DerekWangHUZ/sice-huawei-cup-wireless-2026/docs/FPGA实验板资料参考.md

# FPGA 实验板资料参考（学校《数字系统实验II》）

> 本文档汇总《数字系统实验 II》课程所用 **Artix-7 实验板** 的完整引脚与片上资源约束，
> 全部来自《数字系统实验 II》课程各实验的官方 XDC / 源文件，
> 并与板卡实际行为核对。本仓库 FPGA 工程（`firmware/coprocessor`）的引脚约束以本文为参考。

---

## 1. 板卡识别（务必看清，别用错芯片）

| 项 | 值 |
|---|---|
| FPGA 型号 | **XC7A35T-FTG256-1**（Artix-7，35T，256 脚 FTBGA，速度等级 -1） |
| 默认 I/O 标准 | **LVCMOS33**（3.3V，所有引脚约束都需加 `IOSTANDARD LVCMOS33`） |
| 主时钟 | **50 MHz**，晶振接 `D4` |
| 复位 | **低有效 `rst_n`**，接 `T9`（板上无上拉，设计中必须开内部 PULLUP） |

> Vivado 建工程时 **Project Type = RTL Project**，**Default Part** 选 `xc7a35tftg256-1`。

---

## 2. 时钟与复位（每个工程都必须有）

```tcl
## 50MHz 主时钟
set_property PACKAGE_PIN D4 [get_ports clk]
set_property IOSTANDARD  LVCMOS33 [get_ports clk]
create_clock -period 20.000 -name clk [get_ports clk]

## 复位（低有效）。板上无外部上拉，务必开内部 PULLUP，否则会一直卡在复位态
set_property PACKAGE_PIN T9 [get_ports rst_n]
set_property IOSTANDARD  LVCMOS33 [get_ports rst_n]
set_property PULLUP true [get_ports rst_n]
```

**约束要求**：若设计依赖 `rst_n` 而未启用内部上拉，会出现下载成功
（`End of startup status: HIGH`）但 LED 全不亮的现象——`T9` 未被拉高，
设计持续处于异步复位。**rst_n 必须开内部上拉（或在逻辑里处理成可选）。**

---

## 3. LED（16 颗，直接驱动，高电平点亮）

| 信号 | 引脚 | 信号 | 引脚 |
|---|---|---|---|
| `led[0]`  | **P9**  | `led[8]`  | **R1**  |
| `led[1]`  | **R8**  | `led[9]`  | **G5**  |
| `led[2]`  | **R7**  | `led[10]` | **H3**  |
| `led[3]`  | **T5**  | `led[11]` | **E3**  |
| `led[4]`  | **N6**  | `led[12]` | **P5**  |
| `led[5]`  | **T4**  | `led[13]` | **P1**  |
| `led[6]`  | **T3**  | `led[14]` | **N1**  |
| `led[7]`  | **T2**  | `led[15]` | **M1**  |

- 来源：课程《第六周 实验五（２）矩阵键盘按键控制 LED》约束文件（完整 16 颗）。
  课程 master 资源文件里只示范了 `Q[0..3]` + `CO`(N6)，其余以注释形式给出，与上面 16 颗完全一致。
- **极性**：**高电平点亮**（直接驱动，非反相）。验证方法：`assign led = cnt[24:9]` 时
  `led[0..10]`（对应 `cnt[9..19]`，47 Hz~48.8 kHz）肉眼"常亮"，`led[11..15]` 随比特位升高频率递减，
  即每个 `led[k]` 直接接一个计数器高位，1=亮。
- ⚠️ **板卡特性**：`led[15]`（引脚 **M1**）在本板**不点亮**——
  1Hz 同步闪烁程序下其余 15 颗正常闪、唯独 M1 无输出。属板卡个体硬件问题，**与工程/约束/下载无关**，验收时忽略即可。
- **本项目使用约定**：
  - 板上共 **17 颗 LED**（丝印 LED0~LED16）。课程 XDC 只提供 16 个引脚映射，
    **丝印 LED16 没有引脚映射**，任何比特流都不会驱动它——它不亮是"没接"而非"坏了"。
  - **LED12~LED16 按项目要求禁用**：工程只驱动 `led[0..11]`（主排 12 颗），
    `led[15:12]` 在 `rtl/led_ctrl.v`（`LED_COUNT=12`）与 `rtl/top.v` 掩码下恒输出灭。
  - `led[11]` 兼作链路灯：无链路 0.5Hz 慢闪，已链路每帧闪 60ms（契约 §4.8）。

---

## 4. UART（板上 USB-UART 桥）

```tcl
# set_property PACKAGE_PIN F12 [get_ports txd]
# set_property IOSTANDARD  LVCMOS33 [get_ports txd]
# set_property PACKAGE_PIN F13 [get_ports rxd]
# set_property IOSTANDARD  LVCMOS33 [get_ports rxd]
```
- `txd → F12`，`rxd → F13`（LVCMOS33）。F12/F13 接**板上 USB-UART 桥**
  （板右侧独立 UART USB 口，与 JTAG 口并排），供 PC 串口通信使用，
  **未引出至排针**；外部设备对接 UART 请使用扩展排母的空闲引脚。
- 本项目（`firmware/coprocessor`）S3 → FPGA 的 rxd 使用扩展排母
  **B15**（右排母上排第 1 脚，同排末位 GND），约束见
  `firmware/coprocessor/constrs/pins.xdc`。

---

## 5. 矩阵键盘（按键 / 键盘扫描）

| 信号 | 引脚 | 信号 | 引脚 |
|---|---|---|---|
| `row[0]` | **K3** | `col[0]` | **R12** |
| `row[1]` | **M6** | `col[1]` | **T12** |
| `row[2]` | **P10** | `col[2]` | **R11** |
| `row[3]` | **R10** | `col[3]` | **T10** |

- 来源：master 资源文件 `##Buttons` +《第七周 实验六（２）电子琴》约束。
- ⚠️ **上拉/下拉不一致（官方两处写法不同）**：
  - 电子琴 XDC：`set_property PULLUP true [get_ports {col[3..0]}]`（列线上拉）
  - master 资源文件：`set_property PULLDOWN true [get_ports {col[3..0]}]`（列线下拉）
  - 实际用哪种取决于板子矩阵接法；**建议按键盘扫描惯例“列线输出、行线输入+上拉”对接，并在代码中做消抖**。

---

## 6. 拨码开关 `sw[0..11]`（与复位/数码管地址复用，注意冲突）

| 信号 | 引脚 | 信号 | 引脚 |
|---|---|---|---|
| `sw[0]`  | **T9**  | `sw[6]`  | **P4**  |
| `sw[1]`  | **T8**  | `sw[7]`  | **R3**  |
| `sw[2]`  | **T7**  | `sw[8]`  | **R2**  |
| `sw[3]`  | **R6**  | `sw[9]`  | **N4**  |
| `sw[4]`  | **P6**  | `sw[10]` | **H4**  |
| `sw[5]`  | **R5**  | `sw[11]` | **F3**  |

⚠️ **引脚复用冲突（务必注意）**：
- `T9` 同时是 **`rst_n`（复位）** 和 `sw[0]` —— 二者不能在同一工程里同时当独立信号用。
- `T8 / T7 / R6` 同时出现在数码管译码实验的 `ain[1] / ain[2] / ain[3]`（见第 7 节）。
- 同一工程要用开关又要用复位/数码管时，需分时复用或改接，不要简单把它们全部分配。

**本项目使用约定**（`pins.xdc` §3b）：
- `sw[0]`（T9）因与复位冲突**不可用**；`T8/T7/R6` 与本工程实际用到的数码管
  引脚无冲突（本工程不使用 ain 信号），可安全作为拨码输入。
- 本工程使用 `sw[1]`(T8) = 演示模式总开关、`sw[2]`(T7) = 本地硬静音，
  均开内部 PULLUP；其余 9 位拨码留作扩展，未约束。
- 极性（拨上=1 还是拨下=1）以实板为准；若相反，在 RTL 取反一处即可。

---

## 7. 数码管（7 段 × 6 位）

| 段信号 | 引脚 | 位选信号 | 引脚 |
|---|---|---|---|
| `seg[0]` | **P11** | `an/dig[0]` | **G12** |
| `seg[1]` | **N12** | `an/dig[1]` | **H13** |
| `seg[2]` | **L14** | `an/dig[2]` | **M12** |
| `seg[3]` | **K13** | `an/dig[3]` | **N13** |
| `seg[4]` | **K12** | `an/dig[4]` | **N14** |
| `seg[5]` | **P13** | `an/dig[5]` | **N11** |
| `seg[6]` | **M14** | 小数点 `dp` | **V7**（注释） |
| `seg[7]` | **L13** | | |

- 来源：master 资源文件 `##7 segment display` +《第二周 实验二（２）数码管》约束。
- master 用 `an[0..5]`，数码管实验用 `dig[0..5]`，**引脚完全相同**，仅为命名差异。
- 译码段码（共阴极，段选高电平亮）参考课程 `decoder_7seg`：
  `0→11111100, 1→01100000, 2→11011010, 3→11110010, 4→01100110, 5→10110110, 6→00111110, 7→11100000, 8→11111110, 9→11100110`。

---

## 8. 蜂鸣器与 DAC

**蜂鸣器**
```tcl
set_property PACKAGE_PIN L2 [get_ports buzzer]
set_property IOSTANDARD  LVCMOS33 [get_ports buzzer]
```
- 来源：电子琴实验 XDC。

**DAC（8 位）**
| 信号 | 引脚 | 信号 | 引脚 |
|---|---|---|---|
| `DAC_CS`  | **H2** | `DAC_DATA[0]` | **G1** |
| `DAC_WR`  | **H1** | `DAC_DATA[1]` | **G2** |
| `DACAB` | **J3** | `DAC_DATA[2]` | **F2** |
| | | `DAC_DATA[3]` | **E1** |
| | | `DAC_DATA[4]` | **L3** |
| | | `DAC_DATA[5]` | **K1** |
| | | `DAC_DATA[6]` | **K2** |
| | | `DAC_DATA[7]` | **J1** |

- 来源：master 资源文件 `##DAC`（全部以注释形式给出）。

---

## 9. 板卡特性与验证方法

1. **下载成功标志**：Vivado `Program Device` 日志末尾出现 `End of startup status: HIGH` ⇒ 比特流已配置、DONE 拉高、设计在运行。
2. **时钟验证法**：把 25 位计数器 `cnt` 的高 16 位直接接 `led`（`assign led = cnt[24:9]`），
   若 LED0~10 常亮、11~15 频率递减 ⇒ 50MHz/D4 时钟在跑、led 引脚全对。
3. **`led[15]`=M1 在本板不点亮**（见 §3），属板卡个体硬件问题，非工程问题。
4. **复位要求**：`rst_n`(T9) 必须启用内部上拉，否则设计持续处于复位、LED 全灭。

---

## 9b. 配置 Flash 与上电启动（掉电持久化）

`Program Device`（JTAG）写的是 **FPGA 内部 SRAM，掉电即失**；
> 要让板子自己从 Flash 启动，须把比特流写进板载配置 Flash。

- **器件**：Vivado 硬件管理器自动识别为 Micron **N25Q32-3.3V**（ID：Mfg `20` /
  Type `ba` / Cap `16`），对应 `get_cfgmem_parts` 中的
  **`n25q32-3.3v-spi-x1_x2_x4`**（32Mbit = 4MB）。
- **生成烧写文件**：`write_cfgmem -format mcs -size 32 -interface SPIx1`（见
  `firmware/coprocessor/gen_mcs.tcl`）。`-size 32` 对应 32Mbit；
  `SPIx1` 与工程默认 `SPI_BUS_WIDTH=1` 一致，最保守可靠。
- **烧写入口**：GUI 的 **Program Configuration Memory Device**（只接受
  `.mcs`/`.bin`，**不接受 `.bit`**），或仓库内的无头脚本
  `firmware/coprocessor/program_mcs.tcl`。
  后者内部会先加载 Vivado 自带的 SPI 桥接位流
  （`spi_xc7a35t_pullnone.bit`，位于 Vivado 安装目录
  `data/xicom/cfgmem/`），这是 JTAG 间接访问 Flash 的必要前置步骤；
  GUI 会自动完成这一步，手写 Tcl 时须显式加载，遗漏时报
  `[Labtools 27-3347] Failure to set flash parameters`，其根因见
  `readback_hw_cfgmem` 的 `27-3138 indirect programming
  bitstream was not found`。
- **改 RTL 后必须重新固化**，否则上电运行的仍是 Flash 中原有比特流；临时验证
  可用 JTAG 下载（掉电即失，不影响 Flash 内容）。

### ⚠️ 板级特性：上电不会自动触发配置

**现象**：Flash 烧写成功并通过校验后，断电再上电时板子**不会自动启动**——
`DONE` 保持为 0，数码管/LED/蜂鸣器全无反应。**手动按一下板上 CONFIG 按钮**，
立即正常启动并运行 Flash 中的设计。

**以下因素与该现象无关**（按下 CONFIG 能启动即可佐证）：

| 无关因素 | 依据 |
|---|---|
| Flash 内容/比特流有问题 | 按 CONFIG 能正常加载运行 |
| 启动模式（MSEL）不对 | 按 CONFIG 说明确实在读 SPI Flash |
| 烧写方式/工具链有问题 | `Erase`/`Program`/`Verify` 全部成功，读回校验一致 |
| mcs 格式有问题 | 与 Vivado 自带样例 `ac701_test.mcs` 结构逐字段一致 |

**失效环节仅在于"上电瞬间的自动触发"**。CONFIG 按钮接的是 FPGA 的
`PROGRAM_B`（低有效配置复位）；它能手动生效、上电却不生效，指向板级的
上电复位电路/电源上升沿问题，属**硬件层面**。

**以下设置与上电触发无关**：

- 在 XDC 中设置 `BITSTREAM.CONFIG.PROGPIN/INITPIN/DONEPIN = Pull-up`
  （以 FPGA 内部弱上拉替代板上外部上拉）。
- `CFGBVS` 与 `CONFIG_VOLTAGE` 属性（该设置用于消除 DRC 的
  `CFGBVS-1` 告警，与上电触发无关）。

**本板行为：上电后必须按一次 CONFIG 才会从 Flash 启动。**
该现象属板级上电复位电路/电源上升沿特性，**硬件层面**，软件侧无法规避。

**可行的应对方式**（均需人工或额外硬件）：

1. 上电后按一次 CONFIG 按钮（最简单的方式）。
2. 用 `program_bit.tcl` 经 JTAG 下载（需要电脑，不满足"脱离电脑"要求）。

**若要实现全自动而又不动配置电路**，可用 ESP32-S3 的一个空闲 GPIO
接 FPGA 的 `PROGRAM_B`，上电后由 S3 主动拉低 100ms 再释放，等效于按一次
CONFIG。此方案需增加一根飞线，且需占用 S3 的一个空闲 GPIO。

- 烧写失败不会损坏 JTAG 通路：配置 Flash 内容异常时 FPGA 只是不启动，
  仍可用 `program_bit.tcl` 重新下载比特流。

---

## 10. 最小可复用 XDC（时钟 + 复位 + 16 LED）

新建工程后，把下面内容直接贴进 `pins.xdc`（按需再补 UART / 键盘 / 数码管 / DAC）：

```tcl
## Clock: 50MHz on D4
set_property PACKAGE_PIN D4 [get_ports clk]
set_property IOSTANDARD  LVCMOS33 [get_ports clk]
create_clock -period 20.000 -name clk [get_ports clk]

## Reset (active-low). Board has NO pull-up -> enable internal PULLUP
set_property PACKAGE_PIN T9 [get_ports rst_n]
set_property IOSTANDARD  LVCMOS33 [get_ports rst_n]
set_property PULLUP true [get_ports rst_n]

## 16 LEDs (led[15]=M1 is physically dead on this board)
set_property PACKAGE_PIN P9  [get_ports {led[0]}]
set_property PACKAGE_PIN R8  [get_ports {led[1]}]
set_property PACKAGE_PIN R7  [get_ports {led[2]}]
set_property PACKAGE_PIN T5  [get_ports {led[3]}]
set_property PACKAGE_PIN N6  [get_ports {led[4]}]
set_property PACKAGE_PIN T4  [get_ports {led[5]}]
set_property PACKAGE_PIN T3  [get_ports {led[6]}]
set_property PACKAGE_PIN T2  [get_ports {led[7]}]
set_property PACKAGE_PIN R1  [get_ports {led[8]}]
set_property PACKAGE_PIN G5  [get_ports {led[9]}]
set_property PACKAGE_PIN H3  [get_ports {led[10]}]
set_property PACKAGE_PIN E3  [get_ports {led[11]}]
set_property PACKAGE_PIN P5  [get_ports {led[12]}]
set_property PACKAGE_PIN P1  [get_ports {led[13]}]
set_property PACKAGE_PIN N1  [get_ports {led[14]}]
set_property PACKAGE_PIN M1  [get_ports {led[15]}]
set_property IOSTANDARD LVCMOS33 [get_ports {led[15]}]
set_property IOSTANDARD LVCMOS33 [get_ports {led[14]}]
set_property IOSTANDARD LVCMOS33 [get_ports {led[13]}]
set_property IOSTANDARD LVCMOS33 [get_ports {led[12]}]
set_property IOSTANDARD LVCMOS33 [get_ports {led[11]}]
set_property IOSTANDARD LVCMOS33 [get_ports {led[10]}]
set_property IOSTANDARD LVCMOS33 [get_ports {led[9]}]
set_property IOSTANDARD LVCMOS33 [get_ports {led[8]}]
set_property IOSTANDARD LVCMOS33 [get_ports {led[7]}]
set_property IOSTANDARD LVCMOS33 [get_ports {led[6]}]
set_property IOSTANDARD LVCMOS33 [get_ports {led[5]}]
set_property IOSTANDARD LVCMOS33 [get_ports {led[4]}]
set_property IOSTANDARD LVCMOS33 [get_ports {led[3]}]
set_property IOSTANDARD LVCMOS33 [get_ports {led[2]}]
set_property IOSTANDARD LVCMOS33 [get_ports {led[1]}]
set_property IOSTANDARD LVCMOS33 [get_ports {led[0]}]
```

---

## 11. 板子照片

实验板实物照片（来自课程目录，已存入仓库）：

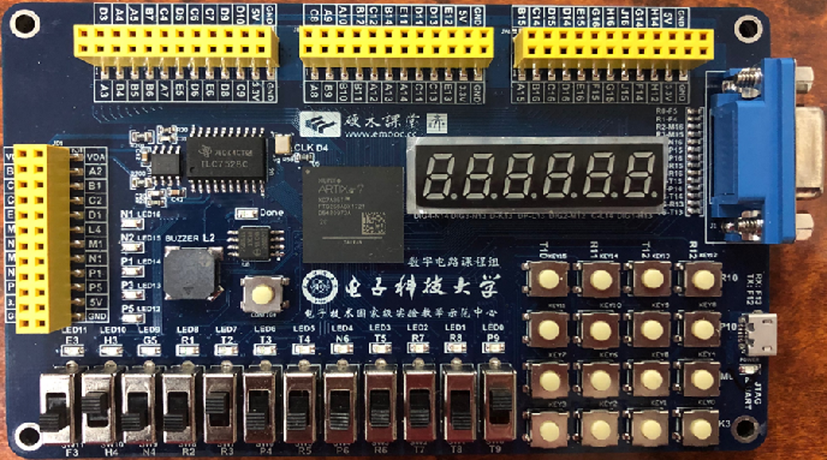
[picture p1: hardware/photos/fpga-board.png]
实验板照片


> 官方原理图不在仓库内；如需引用请置于 `hardware/schematics/`。
