DerekWangHUZ/sice-huawei-cup-wireless-2026/docs/CHANGELOG.md

# CHANGELOG

> 记录本项目架构层面的重要变更与决策依据。代码级细碎改动不在此列。
> 格式参考 [Keep a Changelog](https://keepachangelog.com/zh-CN/1.1.0/)，本项目未对外发布，暂不使用版本号。

---

## [2026-10-31] CSI 上机排查：驱动配置层两层修复 + v6.1 SoftAP ESP_FAIL 坐实

> 目标：打通 real 构建的 SoftAP CSI 采集（sigma_csi 标定的前置）。
> 结果：驱动配置层问题全部修复；剩余一层为 IDF v6.1 驱动对 SoftAP
> CSI 的未文档化拒绝（ESP_FAIL），已实测坐实并转仓库 issue 跟踪。

### 一、构建环境修复（本机）

- ESP-IDF python venv 指向的基座解释器 Python 3.14 已被卸载（本机现为
  3.15.2），venv 启动器失效：pyvenv.cfg 重指 Python315，并以官方 PyPI
  升级 pydantic/cffi/bitarray/charset-normalizer/cryptography(48)/psutil
  ——cryptography 须 <49（约束文件），50.x 会被 idf.py 环境检查拒绝。
- 修复后 `idf.py build` / `flash` 全流程恢复。

### 二、CSI 上机排查（三层定位，前两层已修复）

| 层 | 现象/原因 | 处置 |
|---|---|---|
| 1 | `CONFIG_ESP_WIFI_CSI_ENABLED` 未开：WiFi 驱动初始化时 CSI 能力缺失，`set_csi_config` 直接 ESP_FAIL | sdkconfig 置 y——注意直接改 sdkconfig 会被 confgen 回退（生成头文件中符号消失，机制待查），现以编译注入 `-DCONFIG_ESP_WIFI_CSI_ENABLED=1` 兜底 |
| 2 | v6 起 CSI 与混杂模式耦合：未开 promiscuous 同样 ESP_FAIL | `csi_init()` 内置 `esp_wifi_set_promiscuous(true)`（串口日志 `ic_enable_sniffer` 证实生效） |
| 3 | 满足 1/2 后 `set_csi_config` 仍 ESP_FAIL：延迟到 SoftAP 完全就绪且 STA 推流中（首帧延迟初始化），LLTF-only 与 LLTF+HT-LTF 两种配置均被拒 | **未解**：v6.1 驱动对 SoftAP CSI 的支持变化（未文档化），转仓库 issue；候选路径为 v5.5 工具链采集固件或 STA 模式方案 |

### 三、源码变更（base_station）

- `csi_init()` 内置 promiscuous 使能 + 两种 CSI 配置组合依序尝试；
- `base_station.c` CSI 初始化改为**首帧延迟初始化**
  （`csi_late_init_if_needed`，udp_pose_task 首帧触发）：
  替代原"esp_wifi_start 后立即初始化"的时序；
- `csi_stub.h`/`csi_real.c`/`base_station.c` 头注同步为当前事实口径；
- 失败路径保持 fail-open：CSI 缺失不影响 IMU 主判据，行为与 stub 一致。

### 四、验收证据

- 串口启动日志（COM4）：`ic_enable_sniffer` 证实 promiscuous 生效；
  `set_csi_config try 1/2 failed: ESP_FAIL` 证实双配置均被拒；
- 推流链路正常：`STATS packets=219→1972 frames_ok=100% mag=0.99~1.00g`；
- real 构建编译通过（bin 949,504 B），烧录校验一致。

### 五、未覆盖事项

- SoftAP CSI 的 ESP_FAIL（issue 跟踪）解决前，real 构建的 CSI_Variance
  列仍为 0，CSI_JUDGE_ENABLE 保持关闭（fail-open）；
- sigma_csi 三状态标定、姿态门佩戴标定：待 CSI 采集打通后进行。

---

## [2026-10-26] 摄像头恢复启用 + 全套离线验证收尾 + 文档口径清理

> 三件事：① 摄像头模组恢复可用，`CAMERA_BOOT_ENABLE` 默认翻回 1；
> ② 上一条目遗留的全部离线验证在本机（D 盘仓库机器）补齐；
> ③ 根 README 与 docs/（除本文件）按"当前事实"口径清理历史痕迹表述。

### 一、摄像头恢复启用（联动固件 + 文档）

- 摄像头模组恢复可用（用户确认），`wearable_firmware.ino` 的
  `CAMERA_BOOT_ENABLE` 默认值 0 → **1**（全功能启动：摄像头三段自检 +
  闪光灯 + 网页 + /pic）；宏注释改写为中性的编译期功能开关说明，
  置 0 仍可用于隔离摄像头链路或最小化运行。
- 双向编译验证（arduino-cli 1.5.2 / esp32 core 3.3.12 /
  FQBN `esp32:esp32:esp32cam:PartitionScheme=huge_app,FlashMode=dio,FlashFreq=40`）：
  默认(=1) 与临时置 0 均 **0 error / 8 warning**（全部为既有
  volatile 计数器 `++` 的 `-Wvolatile` C++20 弃用告警）；
  bin 体积 1,090,149 B（=1，34% of 3MB）/ 938,725 B（=0，29%）。
- 2026-10-25 条目中"摄像头硬件故障停用"的前提自此作废。

### 二、离线验证收尾（本机执行，全部通过）

| 验证项 | 结果 |
|---|---|
| 穿戴端固件（两宏配置） | 0 error（见上） |
| 离线自测 | `ALL 19` + `ALL 22 SCENARIOS PASSED`，总 PASS |
| 基站 ESP-IDF v6.1 默认 stub | 0 error/0 warning，bin 947,744 B（分区余量 10%） |
| 基站 `-DBS_CSI_IMPL=real` | 0 error/0 warning，bin 948,992 B（9%） |
| 基站 `-DCSI_JUDGE_ENABLE=1` | 0 error/0 warning，bin 947,776 B（10%） |
| FPGA 无头仿真（Vivado 2026.1） | `SIM RESULT: PASS`（86 项断言） |

### 三、脚本与文档

1. **`run_offline_tests.ps1` 补 lcc64 第二构建**：实测 lcc64 支持 `-D`，
   posture-gate 构建不再对 lcc64 跳过；同时总结果增加 `$postureBuilt`
   硬门禁（第二构建失败 = FAIL，不再可能静默弱化）。
2. **文档口径清理**（根 README + docs/ 除本文件外全部）：删除日期标注、
   修订叙事（"第 N 次上板实测修订/此前为误判/已实现/改回恢复"等），
   统一为现在时态的中性事实陈述；摄像头能力恢复全功能表；顺带修正
   过时数字（离线 17 场景 → 19+22；FPGA 仿真 60 断言 → 86）。
   **firmware/ 内部文档（wearable README、tests README）按指示未动**，
   其中摄像头停用期描述与现默认行为不符，待团队自行刷新。
3. 本机构建注记：idf.py 须在 PowerShell 进程内 `Remove-Item Env:MSYSTEM`
   后经 EIM profile 激活（`env -u`/置空均会被重注入）；仓库内
   `firmware/base_station/build/` 为另一路径机器生成的失效缓存，已删除，
   首次构建请用全新构建目录。

### 四、实机冒烟测试（2026-10-26 当日，基站 + 穿戴端上电）

- **基站（ESP32-S3，COM4/CH343）**：暂存版固件烧录成功（947,872B 校验一致）
  并完整启动——SD 挂载记录 `DATA_115.CSV`、OLED 就绪、FPGA UART 就绪并
  发送音频配置与心跳、`CSI stub active` 初始化日志正确、SoftAP/DHCP 池
  （.2 保留）/UDP 8888 全部就绪，STATS 周期稳定无重启。未接穿戴端时
  `packets=0 state=IDLE`，符合预期。FPGA 板未接入，上行链路未测。
- **穿戴端（ESP32-CAM，COM9/CH340 TTL）**：板上固件实机通过 MPU 初始化
  （WHO_AM_I=0x74）与摄像头自检（`[CAMERA] post-MPU selftest OK: 8601 bytes`）。
  USB 供电不足导致 WiFi 启动阶段看门狗复位（一轮为 TG1WDT、一轮摄像头
  init 返回 0x106 后 TG0WDT 快速复位循环）——同版固件在供电充足时摄像头
  与 MPU 自检可过，属供电问题非固件缺陷；网络链路与抓拍全流程待稳定供电
  （充电宝 5V）后回归。穿戴端烧录须经 MB 底板（自动下载），COM9 TTL 接法
  仅可运行不可烧录。
- **烧录口径修正**：穿戴端 README 移除"按住 IO0、短按 RST"的手动下载步骤
  （本工程烧录由 MB 底板自动完成，与板上按键无关）；穿戴端 README 全文按
  摄像头全功能现状同步改写（§0/§2/§4/§5/§6/§7/§8/§9）。
- **50 Hz 数据链路实机打通**：穿戴端（MB 底板供电）与基站完成全链路——
  基站 `packets=2812 frames_ok=2812 frames_bad=0 mag=0.98g`（静止重力值，
  数值链路正确），穿戴端连续推流 `UDP #3492 fail=0`（新增发送失败计数
  为 0，序号=成功发出帧数语义生效）；WiFi 断线自愈（基站复位后 2.4s 内
  自动重连）实机验证通过。
- **新增操作约束文档（wearable README §5.3）**：CAM 插 MB 底板（烧录姿态）
  与接 MPU 排线（运行姿态）物理互斥——烧录姿态下 MPU 必然离线、不发帧，
  "无数据"属预期；运行姿态下无法烧录，Upload 连不上先核对物理姿态；
  姿态切换须重新上电（MPU 仅在 setup() 初始化）。此前"穿戴端无数据"
  的现象即烧录姿态下的预期表现，非链路故障。

### 未覆盖 / 已知事项（需上机）

- 上机三件套不变：CSI（S3 AP 模式回调确认 → sigma_csi 三状态标定 →
  翻转 `CSI_JUDGE_ENABLE=1` 回归）、姿态门佩戴标定四步、整机联调。
- 穿戴端烧录配置口径：README §6 写 FlashFreq 40MHz，仓库中上一份实机
  烧录构建（arduino 缓存）实际为板默认 80MHz；本次验证按 40MHz。
  两者均可编译，上机时确认一次口径即可。
- 穿戴端 README（firmware/ 内部）仍含摄像头停用期描述（§4/§7/§8），
  与默认=1 的启动日志不同；不影响运行，团队可按需刷新。

---

## [2026-10-25] 离线代码质量加固 + CSI 数据通路落地 + 文档-代码对齐

> 本次全部改动**纯离线验证**（无板）：基站经 ESP-IDF v6.1 完整编译 +
> 离线自测双构建回归；穿戴端无编译环境，逐行人工核验（见"未覆盖"）。

### 一、基站（可编译验证 + 离线回归）

1. **离线自测恢复可移植**：`run_offline_tests.ps1` 编译器/Python 探测参数化
   （gcc → MSVC vcvars → lcc64 后备），并新增**第二构建**
   `test_harness_posture.exe`（`-DPOSTURE_CHECK_ENABLE=1`），两个二进制
   都必须全绿才算 PASS。原脚本硬编码 MATLAB lcc64 路径，换机即失效。
2. **姿态门离线场景组补全**（`POSTURE_CHECK_ENABLE` 的门逻辑 2026-10-18
   已完整落地但从未被离线测试覆盖）：场景 18 校准后跌倒躺平→照常 CONFIRMED、
   场景 19 校准后快速坐下→门拦截不报警（magnitude-only 判定的头号误报源）、
   场景 20 未校准 fail-open 与门关闭行为逐位一致。`gen_frames.py` 新增
   三个姿态场景合成帧（直立校准 2.1s / 躺平重力 +Y 夹角 ~82° / 坐姿 ~6°）。
   `fall_core.h` 姿态门宏加 `#ifndef` 守卫并补**佩戴标定流程四步**注释；
   默认值保持 0（待成员 B 上机标定后再翻转）。
3. **代码级修复**：
   - `fpga_link.c` 发送帧间隔保护由"持锁自旋烧 CPU"改为 `vTaskDelay(1)`
     分片等待（帧间隔语义不变：互斥仍持有、间隔只会更长不会更短）；
   - `settings.c` NVS 写入改**增量脏写**（影子副本 s_saved 对比，只写变更
     key；旧实现每次调节写满 8 个 key，磨损放大 8 倍），同时修复 5 处
     `snprintf(buf, n, 非字面格式串)` 的 format-security 隐患；
   - `sd_log.c` 无卡探活加指数退避（前 3 次逐周期重试，之后 4/8/16 周期
     封顶）：全量 `sd_log_init()`（SPI init+挂载）一次耗几十上百 ms，
     无卡时逐周期重试会周期性阻塞 UI 任务；
   - `fpga_uplink.c` UART 逐字节读改批量读（32B/次）；`s_last_ms`（int64，
     32 位 Xtensa 上跨任务撕裂读）加 portMUX 短临界区；
   - `oled_display.c` 删除内联 isqrt 拷贝，复用 `fall_core` 导出的
     `fall_isqrt_u32`（同算法两份拷贝漂移风险）；遥测页 `row` 缓冲 24→32B
     并对角速度显示加 999.9 物理限幅（否则触发
     `-Werror=format-truncation`）；
   - `base_station.c` DHCP 池 `htonl(0xC0A8040A)` 魔法数改 `IP4_ADDR` 宏。
4. **评估后明确不改**（记录决策防后人重议）：任务看门狗订阅、SoftAP 初始化
   失败向上传播——需上机观察，纯离线阶段不动运行时行为。

### 二、CSI 数据通路（"通感"卖点落地到编译级）

- **新增 `csi_stats.c/h`（纯 C99，进离线自测）**：子载波 IQ→幅度
  （复用 `fall_isqrt_u32`）→单帧子载波间方差（一阶公式
  `(N·Σx²-(Σx)²)/N²`，回调上下文只累加不做除法）→10 帧滑窗平均。
  离线场景 21/22 锁死：方差精确值、ready 状态机、commit 节流（无新快照
  不重复入窗）、滑窗环形覆盖、非法输入拒绝。
- **新增 `csi_real.c`（编译期由 `main/CMakeLists.txt` 的 `BS_CSI_IMPL`
  选择，默认 stub）**：`esp_wifi_set_csi_config`(LLTF only，关闭相邻子载波
  滤波——滤波会抹平方差特征) + `set_csi_rx_cb` + `set_csi(true)`；
  子载波数取 `csi_info->len/2`（不假设固定 64，S3 与 ESP32 classic 数量不同）。
  采集源即穿戴端 STA 的 50Hz 上行包（ESP-CSI 只对本机收发的帧触发，
  esp-csi#247），`csi_feed_packet()` 的调用点天然节流。
- **`fall_core` CSI 辅助判据钩子（`CSI_JUDGE_ENABLE` 默认 0）**：
  `fall_detector_set_csi()` 喂入窗口方差，确认门增加"方差 < sigma_csi"
  分支；未就绪 fail-open（CSI 缺失绝不比纯 IMU 更保守漏报）。宏带
  `#ifndef` 守卫，与姿态门同一开关模式。
- **接口扩展**：`csi_stub.h` 新增 `csi_init()`（esp_wifi_start 后调用），
  stub 为空操作；头注由"6 步 TODO"改写为"已实现/待上机"两栏。
- **三种配置均编译验证通过**：默认 stub / `BS_CSI_IMPL=real` /
  `CSI_JUDGE_ENABLE=1`（默认构建产物与历史行为逐字节同源）。

### 三、穿戴端（无编译环境，人工核验）

1. **实现 `CAMERA_BOOT_ENABLE`（修复"README 有、代码无"的缺口）**：
   wearable README §4/§7 自 c5bd068 起描述该宏及其启动锚点，但对应代码
   未提交。现补齐：默认 0（摄像头硬件故障期）跳过摄像头初始化/三段自检/
   闪光灯/网页服务，打印 `[CAMERA] disabled` / `[HTTP] not started:
   CAMERA_BOOT_ENABLE=0` / `[CAPTURE] disabled` 三锚点（与 README §7
   逐条对齐）；MPU 50Hz 推流与 8889 命令接收（校验+日志）不受影响；
   改回 1 即恢复全部功能。
2. `app_httpd.cpp` 修复 vendored 遗留 bug：`char *part_buf[128]`（128 个
   指针，本意 128 字节 scratch）→ `char part_buf[128]`。
3. `sendImuPacket` 检查 `write/endPacket` 返回值：三步全成才递增
   `packetSequence`（序号=成功发出的帧数），失败计入 `g_udpSendFail`
   随 200ms 诊断行汇报（旧实现失败也递增序号，掩盖发送故障）。
4. 8889 未知命令打印限流（每 5 秒最多一条，端口对全网开放时防刷屏）。
5. 本地跌倒检测阈值与基站 `fall_core.h` 对齐（旧 2.2g/180dps/0.75~1.25g/
   25dps/800ms/3000ms → 3.0g/—/0.65~1.35g/50dps/1500ms/4000ms），
   消除"本地报跌倒、基站不报"的双阈值漂移；注释明确其为仅串口诊断，
   不上报（18B 协议无本地判定字段）。
6. **评估后保留** `wifi_keepalive` 内 `delay(20/50)`：仅发生在链路切换
   时刻（此时数据流本已中断），而 socket 清理时序是上板验证过的修复
   （c5bd068），无法编译+上板验证前不改动。

### 四、文档对齐（代码为准）

- 键映射修正：契约 §4.9 与说明书 §三 原文"上行键号 = 15 - pos（左上角
  KEY15）"改为"= pos（扫描起点一角 KEY0，恒等映射）"——第四次上板反馈
  （2026-10-19 同日修订第 1 条）已实测推翻 15-pos，但两份文档未同步，
  排布图一并纠正。
- 根 README：穿戴端能力表逐项标注停用/可用；目录树补 `CHANGELOG.md`、
  `algorithm/`、`data/` 标注"预留待成员 C 交付"；CSI 表述由"预留接口"
  更新为"数据通路已实现、默认未启用、判据待上机标定"。

### 验证

- 离线自测：默认构建 19 场景 + 姿态门构建 22 场景，全部 PASS
  （MSVC cl 编译，脚本自动探测）。
- 基站固件：ESP-IDF v6.1 + xtensa-esp-elf 15.2.0 完整编译三种配置
  （stub/real/判据开启）全部通过，默认配置 bin 947KB，分区余量 10%。
- CSI API 编译级验证以本机 `esp_wifi.h` 头文件实际签名为准
  （`wifi_csi_config_t` 九字段、`wifi_csi_info_t.len`、`esp_wifi_set_csi_rx_cb`）。

### 未覆盖 / 已知事项（需上机）

- **穿戴端全部改动未经编译验证**（本机无 arduino-cli，沿仓库既有惯例）：
  烧录前建议先 Arduino IDE 编译一次确认零错误，重点看 `CAMERA_BOOT_ENABLE`
  两分支与 `checkFall` 改动。
- CSI 三件上机事项（详见 `csi_stub.h` 头注）：① S3 AP 模式回调确触发
  （`csi_ready()` 变 true）；② 标定 sigma_csi（静止/活动/躺平三状态采集
  CSI_Variance 序列取分界，填 `CSI_FALL_VAR_MAX`）；③ 翻转
  `CSI_JUDGE_ENABLE=1` 并回归全部场景。
- 姿态门待成员 B 确定佩戴方案后按 `fall_core.h` 标定流程四步执行，
  再翻转默认值。
- 本机构建注记：xtensa-gcc 15.2 全并行编译 `esp_lcd_panel_rgb.c` 会触发
  编译器内部错误（ira pass 段错误，间歇性），`-j2` 稳定；另 idf.py 拒绝
  MSYSTEM 环境（Git Bash 会向原生子进程重注入），须在 cmd 内
  `set MSYSTEM=` 后驱动 cmake+ninja——本机入口 `build_bs.cmd`（不入库，
  已加入 .gitignore）。

---

## [2026-10-19] 穿戴端联调收尾：抓拍命令端口、帧缓冲与流稳定性

### 现象与定位

穿戴端接入基站后依次暴露以下问题：

1. **Brownout 无限重启**：`setup()` 走到 `WiFi.mode(WIFI_STA)` 时触发
   `E BOD: Brownout detector was triggered`，随后 `rst:0x3 (SW_RESET)` 循环，
   永远到不了 `WiFi connected`。射频上电瞬间的电流冲击把供电拉到阈值以下。
2. **抓拍无响应、`/pic` 一直 404**：基站侧日志有
   `snap cmd sent to 192.168.4.2:8889`，但穿戴端不闪灯、不存图。
3. **连续出帧能力不足**：`fb_count = 2` 时 `httpd_resp_send_chunk()` 阻塞发送
   会占住缓冲，驱动补不上新帧，`esp_camera_fb_get()` 偶发返回 `NULL`。

### 修复

- **Brownout**：关闭检测器。地址为 `RTC_CNTL_BROWN_OUT_REG`，即
  `DR_REG_RTCCNTL_BASE(0x3ff48000) + 0xd4 = 0x3ff480d4`。检测器在供电临界时
  会无限复位，反而比"电压真崩时死机"更糟。
- **抓拍命令端口**：`udp.begin(8889)` 之前先 `udp.stop()`。
  WiFi 未连上时 `begin()` 会失败且 socket 可能留在半开状态，后续再次 `begin()`
  依然失败；不清理状态就会导致 `commandPortReady` 永久为 `false`，
  `checkCaptureCommand()` 直接返回，抓拍从此不再响应。`wifi_keepalive()`
  重连后的重新绑定同样照此处理。
- **帧缓冲**：`fb_count` 由 2 提升到 4，分辨率在初始化时直接设为 `QVGA`
  （避免先按 `UXGA` 分配再降档）；`stream_handler` 对取帧失败做 10 次重试
  （每次 50 ms），瞬时竞争不再中断已建立的流。
- **诊断计数**：新增 `g_captureCmdRx / g_captureReject / g_captureOk /
  g_captureFail`，经 `/status` 暴露，不接串口即可判断抓拍卡在哪一步。
- **三段自检**：在 `esp_camera_init()`、`setupLedFlash()`、`setupMpu()` 之后
  各取一帧并打印结果，使「初始化成功但取图失败」与「外设干扰」可从串口区分。
- **WiFi 健壮性**：启动等待加入 30 秒重试（重试时同步重设静态 IP）；
  运行期新增 `wifi_keepalive()`，每 3 秒检查、断线 6 秒重连，
  基站重启后无需人工断电。
- **I2C 超时**：`MPUWire.setTimeOut(50)`，避免 MPU 掉线时 Wire 阻塞拖死主循环。
- **摄像头/MPU 失败容错**：任一初始化失败只跳过对应功能，不中断推流主链路。

### 验证

- 姿态推流：基站 `STATS packets=116593 frames_ok=116593`，稳定 50 Hz。
- 三段自检：`selftest OK: 8518 bytes` / `post-LED selftest OK: 8311 bytes` /
  `post-MPU selftest OK: 8779 bytes`。
- 网页：`/` 200（42079 字节）、`/status` 200、`/capture` 200（JPEG）、
  `/stream` 连续 15 秒不断开。
- 抓拍链路：跌倒判定 `IDLE -> PENDING -> CONFIRMED` 后下发
  `snap cmd sent to 192.168.4.2:8889`；`/status` 显示
  `cmd_port_ready=1 cmd_rx=4 ok=4 fail=0`，`/pic` 返回有效 JPEG。

---

## [2026-10-19] 穿戴端固件并入正式工程：异步抓拍 + `/pic` + UDP 8889 命令

### 变更内容

- **穿戴端固件替换为联调版**：`firmware/wearable/main/wearable_firmware/wearable_firmware.ino`
  并入基站联调分支的实现，新增以下能力（协议 §1.2 / §1.3 零改动）：
  - UDP `8889` 抓拍命令处理：校验 4 字节 `55 AA 01 FF`，单轮最多 4 包，非法命令丢弃并打印；
  - 异步抓拍：`capture_worker` 任务（core 0，栈 6144）+ 双信号量，JPEG 存 PSRAM，
    主循环继续 50 Hz 采样，不因抓拍阻塞；
  - 非阻塞补光：取图前 150 ms 预热，约 1 s 后自动关灯；
  - 网络初始化加固：显式 `WiFi.mode(WIFI_STA)`、`WiFi.config()` 失败即停、
    检查 `udp.begin()` 返回值；
  - `[STEP ... ms]` 启动日志，用于定位 `setup()` 阻塞点。
- **网页服务新增 `/pic`**：`app_httpd.cpp` 增加 `latest_photo_handler`，返回最近一次
  UDP 触发抓拍的照片；未抓拍时 404，断电后丢失。
- **基站 DHCP 地址池排除 `.2`**：`wifi_init_softap()` 在 `esp_wifi_start()` 后设置
  `dhcps_lease_t` 为 `192.168.4.10 ~ 192.168.4.100`，避免电脑抢占穿戴端静态地址；
  设置失败只告警，不影响收包主链路。
- **文档对齐**：`firmware/wearable/README.md` 更新为联调版内容（抓拍链路、烧录参数、
  启动日志锚点、9 步验收）；根 README 增加穿戴端能力表与 `/pic` 参数；
  契约 §1.3 补充抓拍实现要点。

### 文档纠错（与实现对齐）

| 位置 | 原表述 | 实际实现 |
|---|---|---|
| `docs/开关按键使用说明书.md` | 人工解除按 KEY1 | **KEY0**（`ui_app.c` 告警态分支） |
| 同上 | 状态区「接入正常 / 异常 N 项 / 穿戴端未接入 / SD卡未插入」 | 「全部正常 / 设备就绪 / 穿戴端无数据 / 串口断开 / 键盘未连接 / 存储卡未插入」 |
| 同上 | X-SHIFT 0~6 像素 | **0~4 列**（`settings.c` 钳位） |
| 根 `README.md` | 设置页 8 项 | **9 项**（`SETTINGS_ITEM_N`） |
| 契约 §2.2 | 离线自测 14 场景 | **17/17** |
| 团队分工方案 | UDP「16 字节」 | **18 字节** |
| 契约 §四 | 标题重复两行、`tl/input_ctrl.v` 代码跨度断裂 | 已修复 |
| 契约 §4.9 | 「音调相换档」 | 「音调互换档」 |
| `pins.xdc` 与 RTL/文档 | `sw_mute` 写作 N4/sw[9] | **T7/sw[2]**（XDC 正确，注释与文档已纠正） |

### 验证

- 基站固件 `idf.py build`：**0 error / 0 warning**，`base_station.bin` = 0xe7660 字节，
  分区余量 10%。
- 离线自测 `test_harness.exe`：**ALL 17 SCENARIOS PASSED**。
- 穿戴端：本机无 `arduino-cli`，未做编译验证；代码来源为已在真机跑通的联调版本，
  本次仅改注释、banner 与一处 TODO。

### 真机联调发现与修复（穿戴端）

上板实测启动日志，定位到以下问题并修复：

1. **Brownout 复位循环**：`setup()` 走到 `WiFi.mode(WIFI_STA)` 时触发
   `E BOD: Brownout detector was triggered`，随后 `rst:0x3 (SW_RESET)` 无限重启，
   永远到不了 `WiFi connected`。关闭检测器后不再复位；地址推导见上一条记录。

2. **摄像头失败中断主链路**：`esp_camera_init()` 失败时若直接 `return`，
   会导致 `WiFi.mode` / `WiFi.config` / `WiFi.begin` / `udp.begin` 全部不执行，
   基站侧表现为「穿戴端无数据」。现改为失败仅记录、`cameraReady` 保持 false，
   后续初始化照常进行；`esp_camera_sensor_get()` 的返回值一律判空。

3. **摄像头 `0x106`**：属排线接触问题。断电后重新插紧排线座并锁扣，
   `esp_camera_init` 即返回 `0x0`，摄像头本身正常。

### 烧录方式

穿戴端烧录需 CAM 插在 MB 板上：该板带有 DTR/RTS 驱动的自动下载电路，
`esptool --before default-reset` 可直接进入下载模式，无需按键。
杜邦线接法下 CH340 的 DTR/RTS 只对 EN 有效、IO0 始终为高，
芯片停在 `boot:0x13`，无法由软件进入下载模式。

### 帧缓冲与烧录速度

- 帧缓冲 `fb_count = 4`、`grab_mode = CAMERA_GRAB_LATEST`，
  `stream_handler` 对取帧失败做 10 次重试，避免瞬时竞争中断视频流。
- 烧录参数：`--baud 921600`、单次 `write-flash` 写完 bootloader/分区表/应用，
  1 MB 应用约 16 秒。

---

## [2026-10-19] 声光交互升级：OLED 多页面 + 键盘可视化设置 + 演示模式 + 数码管"说人话"

> **协议 §4 扩展**：新增 `0x03 SET_AUDIO` 下行命令与 FPGA→S3 上行 UI 帧
> （`0x80` 快照 / `0x81` 键事件，§4.9），帧格式/帧长/校验规则一律不变；
> 新增固件源文件 4 个 + RTL 源文件 2 个，`rebuild.tcl` / `run_sim.ps1` /
> `CMakeLists.txt` 源清单同步。

### 变更内容

**一、数码管整屏"说人话"（修 `St----` 看不懂）**

问题：原布局"2 位缩写助记符 + 4 位读数"中，`St----` 这六个字符整体无人能懂
（"St"是什么缩写、四个横杠是什么，不看文档无法破译）。

- **`rtl/seg_display.v` 重写为完整英文常用词 + 带单位数值**：
  无链路 `HELLO`（0.5Hz 慢闪）/ 静止 `rEAdy` / 走动 `run` /
  待确认 `N.NNG`（4Hz 快闪，单位 G，右对齐）/ 告警 `FALL`（3.3Hz 急闪）。
  段码表扩充 `H E F r u n y` 等字形。
- **新增"无链路"态**（`cmd_decoder` 增 `ever_linked` 锁存）：与"已链路无遥测"
  在字形与闪烁频率上双重区分，开机一眼可读。
- **告警读数移到 OLED**：告警屏新增"冲击 N.NNg"定格行（S3 在确认时刻锁存），
  数码管只承担最响亮的 `FALL`；原"告警期间老化冻结"逻辑随读数移出而删除。
- 演示场景专用画面：走灯 `Ld NN`、段码自检（全 6 位同字符步进 + dp 交替）、
  音调档 `t1..t3`。
- 3s 遥测老化看门狗保留（作用于待确认数值）；演示合成值经 `stale_en=0`
  永不老化。

**二、OLED 多页面 + 键盘可视化设置（S3 侧）**

- 新增页面：P0 状态（保留原中文大字屏，告警时追加冲击行）、P1 遥测
  （幅值/三轴/角速度/帧率/16 柱幅值历史条形图）、P2 系统（IP/信道/运行时长/
  SD/坏帧/链路状态/判定参数一览）、P3 设置、P4 演示。页面优先级：
  真实告警 > 演示 > 设置模式 > 键盘锁定 > 可选轮播 > 默认 P0。
- **输入以 4×4 矩阵键盘为主**（FPGA 扫描+20ms 消抖，事件上行报告）：
  1~5 翻页、6 轮播开关、A/B/C/D 设置导航、0/# 取消；演示模式 0~7 场景直选、
  # 场景+1、C/D 场景内调参。拨码开关为辅：sw[1](T8)=演示总开关、
  sw[9](N4)=本地硬静音，其余 9 位留作扩展。
- 新增 `settings.c`：8 设置项（OLED 对比度 0x81 运行期可调、轮播开关/周期、
  遥测刷新周期 0.5/1/2s、待确认提示音、蜂鸣器使能、音调三档、恢复出厂），
  NVS 持久化，即改即存即生效；上电恢复后经 0x03 下发 FPGA。
  **判定语义参数（阈值/确认窗口/解除判据）刻意不进设置页**。
- 字库增补 19 字（冲击/设置/演示模式/场景/静止/灯/自检/剧本/遥/系统），
  `gen_cjk16.ps1` 支持 `-Only` 参数化渲染。

**三、演示模式**

- **FPGA 本地场景**（拨码 sw[1]=1，键盘 0~7 选，**单板无需 S3**）：
  1 静止 / 2 走动 / 3 待确认（合成读数 C/D 微调）/ 4 告警 / 5 走灯诊断
  （兼作丝印↔引脚映射核对）/ 6 段码巡检+蜂鸣器三档音调试听（C/D 换档）。
- **S3 全链路剧本**（场景 0）：demo 任务按剧本下发与真实事件逐字节相同的
  `SET_STATE/ALARM/CLEAR` 序列；真实判定后台继续，**真实 ALARM/CLEAR 永不
  抑制、直通突破演示画面**（安全优先）；`fpga_link` 增发送互斥锁支持多任务。
- OLED P4 演示页：场景名 + 预期声光表现清单 + 剧本进度。

**四、板间链路双向化**

- FPGA 新增 `uart_tx.v` + `input_ctrl.v`（键盘扫描/拨码消抖/上行组帧）；
  上行 `0x80` 快照（demo/mute/场景位域，变化即发 + 1s 心跳）与 `0x81`
  键事件（深度 8 队列）。**fpga_txd 现阶段约束在 F12（板上 USB-UART 桥）**，
  电脑接 UART USB 口即可直接观测上行帧字节；对接 S3 时把约束改到扩展排母
  空闲脚、飞线至 S3 GPIO18（UART1 默认 RX）。S3 新增 `fpga_uplink.c`
  （RX 任务）与 `ui_proto.c`（纯 C99 解析，离线自测场景 16 覆盖）。
- S3 侧 UART1 驱动的 RX 缓冲（256B）首次投入使用；`board_pins.h` 避让清单
  增补 GPIO18。

**五、LED 与蜂鸣器**

- **LED12~16 按项目要求禁用**：`led_ctrl.LED_COUNT=12` + top 掩码，`led[15:12]`
  恒输出灭（仿真全程断言）。板上 17 颗 LED（丝印 LED0~16）中丝印 LED16
  无课程引脚映射、从未被任何比特流驱动——它不亮是"没接"而非"坏了"；
  `led[15]`(M1)"驱动也不亮"的个体缺陷落在禁用组内，不再影响验收。
- **`led[11]` 复用为链路灯**：无链路 0.5Hz 慢闪 / 已链路每帧闪 60ms（遥测
  1Hz 即 1Hz 心跳），走动/待确认动效叠加该位。
- **蜂鸣器运行期可配置**：`0x03 SET_AUDIO`（静音/待确认提示音/载波半周期），
  静音优先级高于一切发声（含 POST——上电不再"必响两秒"）；演示场景 6
  三档音调试听解决"共鸣点不对要重综合"的调试循环。

### 决策依据

1. **为什么键盘为主、拨码为辅**：页面切换/设置导航/场景选择是"按一下动一格"
   的交互，矩阵键盘 16 键天然匹配；拨码是"持久电平"，只适合演示总开关与
   硬静音这类防误触的驻留状态。拨码当步进按钮用的方案因交互笨拙被否决。
2. **为什么演示模式的显示所有权放 S3（而非 FPGA 本地强制）**：剧本下发的是
   与真实事件逐字节相同的帧，等于在演示中完整验证下行链路；FPGA 只需透传，
   不复制一份场景状态机。FPGA 本地场景仍保留（场景 1~7），保证单板（无 S3）
   可演示；两种模式靠"演示场景号"天然互斥。
3. **为什么真实 ALARM/CLEAR 永不抑制**：演示是排练场景，真实跌倒必须突破；
   FPGA 侧仲裁 `disp_alarm = alarm_on | POST | demo_scene4`，剧本任务在真实
   告警期间自动挂起、退出演示时向 FPGA 重同步真实状态。
4. **为什么数码管改"整屏英文词"**：评审反馈明确指向"`St----` 六个字符放一起
   不知道是什么意思"——缩写助记符本身不可读，任何"更好记的缩写"都不解决
   问题；完整常用词（HELLO/rEAdy/run/FALL）+ 数值带单位（N.NNG）让六个字符
   自解释。状态语义的中文说明由 OLED 承载（OLED 本就是中文大字屏），两者
   各司其职：数码管=远距离状态信号，OLED=近处信息屏。
5. **为什么上行链路先行约束在 F12**：排母空闲脚需上板指认（同当年 B15 的
   流程），而 F12 接板上 USB-UART 桥、零接线即可在电脑串口逐字节验证上行
   帧；S3 侧 UART1 RX 引脚（GPIO18）与解析代码先行落地，接板时只改 XDC 一行。
6. **LED12~16 禁用的边界**：板上丝印为 LED0~LED16（17 颗），禁用 LED12~16
   后可用组为 LED0~11（12 颗）；若上板走灯实验发现丝印为 1 基编号，则收缩为
   11 颗——`LED_COUNT` 一处参数即可切换，走灯场景（演示场景 5）即核对工具。

### 验收证据

- **FPGA 无头仿真**：`SIM RESULT: PASS`，60 项断言全过——原 9 类场景
  （POST/遥测/老化/ALARM/CLEAR/坏帧/未知命令/重同步）零回归 + 新增词形
  （HELLO/rEAdy/run/FALL/1.02G/3.40G/3.30G）、无链路慢闪、链路灯双态、
  上行 0x80/0x81 逐字节捕获、演示 8 场景（含 C/D 调值 330/音调换档 t2）、
  真实 ALARM 突破演示、双静音（含 POST）、0x03 运行期改音调（载波边沿计数
  对比）、待确认提示音、`led[15:12]` 全程恒灭不变式。
- **Vivado 无头综合/实现/比特流**：`BITSTREAM_OK`，
  `All user specified timing constraints are met`；1560 LUT（7.50%）/
  1094 FF（2.63%）；新增键盘 8 脚 + 拨码 2 脚 + txd 引脚约束无冲突。
- **S3 固件**：`idf.py build` **0 error / 0 warning**，
  `base_station.bin` = 938,672 B（1M 分区余 10%）。
- **离线自测**：**16/16 全过**（原 15 场景零回归 + 新增场景 16：
  ui_proto 快照/键帧/滑动重同步/坏校验/未知命令）。
- 字模：19 个新 CJK 字形由 `gen_cjk16.ps1` 渲染并输出 ASCII 点阵图逐字目视。

### 未覆盖 / 已知事项（需上机）

- **上板首验三件事**（一次性调试比特流可并行完成）：
  ① LED 逐颗走灯 → 丝印 LED0~16 与引脚映射定案（顺带回答"LED16 是否坏"
  ——大概率是"无引脚映射，从未被驱动"）；② 拨码极性（PULLUP 假设验证）；
  ③ 键盘扫描方向与丝印布局核对（行驱列读 + 列上拉，无响应则行列对调）。
- **上行链路接线**：把 `fpga_txd` 约束从 F12 改到扩展排母空闲脚并飞线至
  S3 GPIO18（当前版本电脑串口即可验证上行帧，S3 侧代码已就绪）。
- OLED 五个页面、设置 NVS 持久化、演示 8 场景的真机目视/试听清单尚未执行
  （板卡未连接）；FPGA 需重新固化（`gen_mcs.tcl` + `program_mcs.tcl`）。
- 板卡既有问题不变：上电不自启动需按一次 CONFIG（见 §9b）；S3 空闲路径
  `SO_RCVTIMEO` 不生效（既有缺陷，与本轮改动正交，演示剧本不受其影响）。

### 同日修订（第二次上板反馈）：左边缘 / 主页接入状态 / 人工解除 / 说明书

1. **边缘补偿改为"只让出左侧"**：实测右侧完整、仅左侧约 2 列被遮挡。
   新增绘制安全区宽度 `s_draw_w = 128 - x_shift`，所有绘制边界判断改用它，
   推送时仍整体右移 x_shift 列——内容落在 `[x_shift, 128)`，**右侧满幅可用**
   （此前右侧会被裁掉同宽内容）。X-SHIFT 范围扩到 0~6（默认 2，NVS 持久化）。
2. **P0 主页底部改为硬件接入状态区（中文）**：page6 总述「接入正常 / 异常N项」，
   page7 明细「穿戴端未接入 / FPGA未连接 / 键盘未连接 / SD卡未插入」，
   文本超宽自动横向滚动（新增 `blit16_clip()` 带符号 x 裁剪 + `marquee_cjk()`）。
   原 `PKT/SEQ`、`SD/F/坏帧` 两行移到 P2 系统页。
   新增 18 个字模（接入未异项穿戴卡插连按键全部就绪人工已）。
3. **告警人工解除**：`fall_core` 新增 `fall_detector_force_clear()`（仅
   CONFIRMED→IDLE，其余状态拒绝且不改字段，不动阈值与自动解除判据）；
   `base_station.c` 以 `g_manual_clear_req` 跨任务传位（保持单一写入者纪律），
   在判定任务两条路径上轮询执行；`ui_app.c` 告警期间 KEY1 二次确认
   （3s 内两次），成功后大字区显示「已解除」。
4. **新增 `docs/开关按键使用说明书.md`**：上电顺序、拨码 SW2/SW3、KEY0~15
   速查、五个页面、9 项设置、8 个演示场景、告警解除、接入状态含义、排障表。
   README 目录结构与契约 §4.5 第 7 条已指向该说明书。

验证：`idf.py build` 0 error/0 warning（bin 943KB）；离线自测 **17/17**
（新增场景 17：force_clear 的 CONFIRMED 可清除 + 非告警态拒绝且不改状态 +
计时字段归零）；经 COM4 烧录上板。FPGA/RTL 本轮无改动（无需重烧 mcs）。

---

真机联调后按实测反馈修正 5 项：

1. **键盘放弃 ABCD#/* 丝印假设，统一为 KEY0~KEY15 编号**：`input_ctrl.v` 删除
   `silk_digit` 置换表，改为 `key_number()`（默认按行主序原样输出编号，若丝印
   顺序不同只改这一处，上行帧与本地演示选择共用同一编号）。上行 `0x81`
   直接报告 KEY 编号；S3 侧 `ui_proto.h` 键定义同步为 `UI_KEY_0..15`。
   导航重排：KEY13 循环翻页、KEY14 进设置、KEY15 蜂鸣器开关、KEY1 回主页；
   设置页 KEY14/15 移光标、KEY12/13 调值、KEY1 退出；演示页 KEY0~7 选场景、
   KEY8 下一个、KEY9/10 调参。
2. **拨码重新分配**：SW2(T8)=本地硬静音、SW3(T7)=演示模式总开关（SW1=T9 与
   复位冲突不可用）。XDC、契约 §4.9、README 同步。
3. **P4 演示页版面重排**：场景名（CJK，page2~3）、声光表现（page4）、剧本
   进度（page5，改为 ASCII `STEP n/5`）、键位提示（page7），中英文不再重叠；
   补「待确认」「预留」缺字（方框问题根因）。
4. **页码不再串页**：`draw_title` 支持 `page_no=0` 不画页码（P0 主页保持干净）；
   页面切换与设置退出路径调用 `oled_force_full_refresh()` 强制整屏重刷，
   彻底清除上一页残留像素（含页码）。
5. **OLED 左右边缘补偿**：实测本屏左右各约 2 列被外框遮挡。`oled_flush()`
   改为在推送前把安全区内容整体右移 `s_x_shift` 列、边缘留黑；
   新增设置项 **X-SHIFT（0~4px，默认 2）** 运行期可调并存入 NVS。

验证：FPGA 仿真 `ALL CHECKS PASSED`（按键编号断言已同步）→ 重新综合/生成
mcs 并烧 Flash（`MCS_PROGRAM_OK`）；S3 `idf.py build` 0 error/0 warning 后
经 COM4 烧录（`Hash of data verified`）。

---

上板烧录后对 OLED 功能复审，按裁定确立**演示豁免**原则并修正告警接管：

- **演示模式（拨码 sw[1]=1）对真实状态完全豁免**：`resolve_page` 把演示提到
  最高优先级——真实告警不抢 OLED 屏；`demo_task` 删除告警挂起分支，剧本按
  时间表无干扰推进。真实告警的安全表达由 FPGA 物理输出穿透（ALARM/CLEAR
  直通，蜂鸣/LED/数码管 FALL），演示退出后 OLED 立即回到真实状态（含告警屏）。
- **唯一安全例外**：剧本"解除"步的 CLEAR 在真实告警锁存期间被抑制（否则
  剧本会掐断真实告警蜂鸣；重叠期 FPGA 画面本就被真实告警覆盖，演示无感）。
- **P0 告警屏增强**：`T+NNs` 告警持续秒数 + `MUTE` 有效静音标识
  （拨码上报位 | 设置项，相或）；告警解除后大字区显示「解除」2s（新增
  解/除 2 字模）。
- **P1 遥测页数据新鲜度**：数据流停摆（DATA_TIMEOUT）后 a/三轴/角速度显示
  `--`、条形图熄灭——与 FPGA 3s 老化同语义，不再显示过期值。
- **P2 增 `LINK OK/--`**（可穿戴推流存活）；**P4 非演示态显示待机指引**
  （"sw[1]=ON -> demo"）；**各页标题栏右上角页码 N/5**。
- **恢复出厂两步确认**（3s 内按两次 D，`D AGAIN!` 提示）。
- 验证：`idf.py build` 0 error / 0 warning 后经 COM4 重烧 S3。

---

### 同日修订（第三次上板反馈）：键位反序 / SW 编号 / 演示页中文化 / 主页异常明细

1. **键盘编号反序**：实测丝印左上角是 KEY15、右下角是 KEY0，与矩阵扫描
   行主序相反。`key_number(pos) = 15 - pos`（一处集中），上行键号与本地
   演示场景选择同步生效；仿真按键模型与断言按丝印序号重写，`SIM RESULT: PASS`。
2. **拨码编号更正**：板上拨码丝印从 SW1 起（T9 是复位键、不是拨码）。
   故 **SW1(T8)=演示模式总开关、SW2(T7)=本地硬静音**。XDC/契约/说明书同步。
3. **P4 演示页全中文化并删去无信息行**：原「S3 drives real frames」
   「K0-7 SEL K8 NXT MUTE」等英文删掉，改为——
   page2~3「场景N 名称」、page4「该场景正在做什么」、page5「该场景声光表现」、
   page6「第N步 共5步」、page7 保留 KEY 编号提示（硬件标识）。
4. **主页异常不再只写"异常N项"**：page6 直接列具体原因（如「穿戴端无数据
   键盘未连接」），page7 给处置建议（「查穿戴端电源 查键盘排线」），
   两行都做横向滚动（`marquee_next()` 按宽度决定是否滚动），全正常时
   显示「接入正常 / 全部设备已就绪」居中不滚动。

验证：FPGA 仿真 `SIM RESULT: PASS` → 重综合/mcs/烧 Flash；S3 `idf.py build`
0 error/0 warning（945KB）→ COM4 烧录；字库经脚本一次性补齐至 71 字。

---

### 同日修订（第四次上板反馈）：键位映射回归恒等 + 演示页/状态区重做 + 链路灯柔化

1. **键位映射纠正**：按实测"按 1 进设置、按 0 下移、按 2/3 调值、按 14 回主页"
   反推出丝印编号 = 扫描位置 pos（此前的 `15-pos` 翻转是错的）。
   `key_number(pos) = pos`；仿真按键模型与断言同步还原，`SIM RESULT: PASS`。
2. **键位语义重排为直觉布局**：正常模式 KEY0 回主页 / KEY13 翻页 /
   KEY14 进设置 / KEY15 蜂鸣器，告警时 KEY0 二次确认解除；
   设置页 **KEY0/KEY1 移光标、KEY2/KEY3 调值、KEY14 退出**；
   屏幕底部提示同步为 `K0/K1 sel  K2/K3 +/-  K14 exit`。
3. **每个按键都打印串口日志** `KEY = n (mode)`：键位异常时直接读日志定位，
   不必再靠行为反推（本轮正是靠此来避免下一次猜测）。
4. **演示页改为英文紧凑行**：根因是 16x16 中文字模占 2 页，`page4/page5`、
   `page6/page7` 相邻绘制导致后一行压在前一行下半（截图中的"一坨"）。
   现每行独占 1 页（ASCII 6x8 不跨页）：`Scene N: Name` / 动作 / 声光 /
   `Step n of 5` / 按键提示，标题仍中文。
5. **主页异常文案与滚动**：字库补齐至 95 字并脚本穷举校验
   （`display CJK used=31 missing=0`，零缺字）；文案改为
   「设备名:故障」+「怎么办」两行（如 `键盘:未通` / `查C14到GPIO18`）；
   滚动速度 1 列/帧 → **3 列/帧**。
6. **LED11 链路灯柔化**：READY 态原为每 2s 满亮 60ms 硬闪，与 LED0 呼吸灯
   对比刺眼、观感像故障。改为静止态低亮度（48/255）短脉冲；走动/待确认/
   告警仍满亮；无链路仍 0.5Hz 慢闪。

验证：FPGA 仿真 PASS → 重综合/mcs/烧 Flash（`MCS_PROGRAM_OK`）；
S3 `idf.py build` 0 error/0 warning（946KB）→ COM4 烧录。

---

## [2026-10-18] 掉电固化（配置 Flash）+ 数码管改为实时遥测读数

> **协议 §4.3 / §4.5 / §4.8 修订**：复用 `SET_STATE` 自定稿起即为保留的 `p2`
> （16 位）传递实时合加速度，帧长、命令码、校验规则一律不变。S3 侧需重编重烧
> 才能看到实时读数——未升级的 S3 只在状态边沿发 `p2=0x0000`，数码管会先显示
> `00.00`、3s 后因停止刷新而老化成 `----`（功能不回退，只是没有读数）。

### 变更内容

**问题一：重新上电后配置丢失**

原链路只有 `program_bit.tcl`（JTAG 写 FPGA SRAM），**断电即失**——每次上电都要
重烧一次。板载 Micron N25Q32 配置 Flash 一直在，缺的只是"把 `top.mcs`
写进去"这一步。

FPGA（`firmware/coprocessor`）：

- **新增 `program_mcs.tcl`**：无头把 `top.mcs` 烧进板载配置 Flash，与
  `program_bit.tcl` 同构（同样的 `xc7a35t` 器件型号护栏），并额外：
  显式指定存储器件 `n25q32-3.3v-spi-x1_x2_x4`（与 `gen_mcs.tcl` 的
  `-size 32 / SPIx1` 对应），开启 ERASE/PROGRAM/VERIFY、关闭 BLANK_CHECK，
  打印 `MCS_PROGRAM_OK`。缺 mcs 报 `MCS_MISSING`、器件不匹配报
  `CFGMEM_PART_MISSING`。
  脚本内会自动定位并加载 Vivado 自带的 SPI 桥接位流（JTAG 间接访问 Flash 的
  必要前置步骤，GUI 会自动做、手写 Tcl 容易漏）。
- 改完 RTL 必须重跑 `gen_mcs.tcl` + `program_mcs.tcl`，否则 Flash 里仍是旧
  比特流。`program_bit.tcl` 保留为"改完立刻看现象"的临时手段。
- **`pins.xdc` 补 `CFGBVS` / `CONFIG_VOLTAGE`**：消除 DRC 的 `CFGBVS-1`
  告警，明确配置 bank 为 3.3V。
- ⚠️ **固化已成功，但上电仍不会自动启动**——需按一次板上 CONFIG 按钮，
  详见本条目末尾"未覆盖 / 已知问题"。
- `docs/Vivado工程移植方案.md` 补目录项与固化小节。

**问题二：数码管"看不懂 + 浪费位数"**

原显示只用了 6 位中的 2 位（`S0`），告警时还有两位是固定的 `--`；观众看不出
数字含义。实测反馈："显示数字是什么意思？要让人明白，并且不要只是显示几个
固定的数字/字母，这样太浪费数码管了。"

- **`rtl/seg_display.v` 重写为「2 位状态助记符 + 4 位实时合加速度读数」**：

  | 位 | 内容 |
  |---|---|
  | `an[5]` `an[4]` | 状态助记符：`St` 静止 / `Go` 走动 / `Pd` 待确认 / `AL` 告警 |
  | `an[3]`~`an[0]` | 合加速度 "XX.XX"，单位 g，`an[2]` 的 dp 作小数点 |

  例：静止 `St01.00`，走动 `Go01.24`，冲击 `Pd03.40`，告警 `AL03.40`。
  6 位全部承载信息，且读数随运动实时变化——既是信息也是存活指示。
- **段码表补齐**：原表只有 `0/1/2/3/F/A/L/S/-/空`，现补 `4~9`、`t`、`o`、`G`、
  `P`、`d`。
- **取消小数点"流水点"动画**：`dp` 现在承担小数点语义，与流水动画冲突；
  告警的整屏 3.3Hz 急闪、待确认的 4Hz 快闪保留（快闪对象改为助记符 2 位，
  读数位保持稳定可读）。
- **`rtl/cmd_decoder.v` 新增 `mag_x100[15:0]` / `mag_valid` / `mag_update`**：在
  `SET_STATE` 分支锁存 `p2`（`{n5,n4}` 小端）。`p2 == 0xFFFF` 为"暂无有效遥测"
  哨兵，此时读数位显示 `----` —— **绝不显示一个假的 `00.00`**。
- **FPGA 侧遥测 3s 老化看门狗（`TELEM_STALE_DIV`）**：`SEG_DISPLAY` 自己计时，
  超过 3s 没收到有效遥测就把读数切成 `----`。这是本轮排查中发现的必要补强：
  实测该 IDF 构建下 S3 的 `SO_RCVTIMEO` 不生效，收包任务在无数据时**阻塞在
  `recvfrom` 上**，因此"S3 主动发哨兵"这条路径在数据彻底停摆时并不可靠
  （详见"决策依据"第 6 条）。老化放 FPGA 侧后，读数真实性不再依赖 S3 行为，
  并且在 testbench 里可精确断言。
  **告警期间老化计时器冻结**：契约 §4.5 第 2 条要求确认跌倒后不再发 `SET_STATE`，
  若仍按 3s 老化，告警画面的读数会在 3s 后变成 `----`——那不符合设计意图。
  冻结后读数定格为冲击幅值直到告警解除（testbench 已加断言，观察窗口 3ms
  远超测试用 2ms 阈值，确认 `mag_fresh` 保持为 1）。
- `rtl/top.v` 增加两路连线；`sim/tb_top.v` 改为按位快照捕获 6 位字形组合，
  新增遥测读数（`01.02`/`03.40`）、哨兵 `----`、助记符 `St/Go/Pd/AL` 断言，
  取代原先针对 `FALL--` 的零散字形断言。

基站（`firmware/base_station`）：

- **`main/fall_core.c` 新增 `fall_acc_mag_centi_g()`**：把三轴原始 ADC 值换算成
  0.01g 单位的合加速度幅值。**纯整数逐位开方实现**，不引入 `math.h`——该文件
  必须保持纯 C99，因为离线自测宿主程序直接 `#include` 它（纪律见
  `tools/offline_test/test_harness.c` 文件头）。
- **`main/fpga_link.c` 新增 `fpga_link_send_state_telemetry()`**：`SET_STATE`
  携带遥测；周期刷新帧走 `fpga_link_send_cmd_ex(..., verbose=false)`，日志降到
  DEBUG，避免 1Hz 刷屏。新增 `FPGA_TEL_NO_DATA = 0xFFFF` 哨兵常量。
- **`main/base_station.c`**：新增 `FPGA_TEL_PERIOD_MS = 1000u` 与
  `fpga_telemetry_tick()`，1Hz 重发遥测刷新帧，并遵守两条约束：
  ① `CONFIRMED` 期间停发（保持"确认跌倒后只发 ALARM"的既有语义，同时让告警
  画面上的读数**定格为冲击幅值**，正好是最有信息量的数字）；
  ② 数据流掉线（`DATA_TIMEOUT_MS`）时发 `0xFFFF` 哨兵而非上一帧读数。
  上电首帧同步改为 `SET_STATE(0, 0xFFFF)`。
  状态变化沿的下发也改携带当前幅值，避免读数滞后一次刷新。

### 决策依据

1. **为什么复用 `p2` 而不是新增命令码**：`p2` 自协议定稿起就是保留位，所有
   发送方一律填 `0x0000`，`cmd_decoder.v` 早已解出 `n4`/`n5` 却完全忽略。
   复用它不新增命令码、不改帧长与校验规则，且 FPGA 对重复 `SET_STATE` 完全
   幂等（只做锁存、不触发动作），因此周期刷新不产生副作用。新增命令码则要
   同时改 §4.3 表、白名单、S3 与 FPGA 两侧，收益相同而风险更大。
2. **为什么用 0xFFFF 作哨兵**：int16 输入下合加速度的理论上限是
   `isqrt(3*32767²) = 56754` LSB → `2771`（27.71g），**永远到不了 65535**，
   所以哨兵与合法值不可能混淆（离线自测场景 15 把这一点连同各换算点一起钉死）。
3. **为什么告警期间停发遥测**：契约 §4.5 第 2 条明确"确认跌倒后只发 ALARM，
   不发 SET_STATE(3)"。停发同时满足该条与"读数定格在冲击幅值"的显示需求，
   一个约束解决两个问题。
4. **被否决的方案**：纯本地动画（用 FPGA 本地计时器/计数器凑数字）——计数器
   不是信息，仍属"固定的数字"，达不到用户诉求；保留 `FALL` 文字——占 4 位只剩
   2 位给数值，精度不足且仍浪费。
5. **固化失败可恢复**：`program_mcs.tcl` 只在显式指定器件、且 mcs 存在时动作；
   烧写失败不影响 JTAG 可用性，随时可用 `program_bit.tcl` 恢复现场。
   注意：板卡若被跳线设为 JTAG 启动模式，上电不会从 Flash 加载（属上机首查项，
   见 `docs/FPGA实验板资料参考.md`）。
6. **为什么遥测老化放在 FPGA 侧（本轮排查发现的新问题）**：`base_station.c`
   给收包 socket 设了 100ms `SO_RCVTIMEO`，用于"数据停摆时也要跑
   `fall_detector_tick`"。实机验证发现**该超时在本 IDF 构建下不生效**：
   断电重启后连续观察 25s（PowerShell 直读串口 + `idf.py monitor` 两种方式），
   日志停在 `main_task: Returned from app_main()`，`STATS` 一次都没打印；
   而同一份日志在"有帧到达"时会正常打印 `STATS`。这与历史实测记录
   （"两场景间 33s 无数据，**收到下一帧时**才判 WALK→IDLE"）完全吻合——
   即空闲路径从来只在被数据唤醒时才跑。
   曾用 `select()` 显式 100ms 超时替代 `SO_RCVTIMEO` 重新编译烧写，实机表现
   相同（仍无 `STATS`），因**无法在无数据场景下取得可验证的改善**而回退，
   以免改动已实测通过的主链路。这条属于既有缺陷、与本次两个需求正交，
   已如实记录待后续单独排查（记录见 `base_station.c` 内的注释）。
   对策：把"读数不能过期"的责任放到 FPGA 侧（第 2 条的 3s 老化），
   这样即使 S3 空闲路径不工作，显示也不会骗人。

### 验收证据

- FPGA 无头仿真：`SIM RESULT: PASS`，含新增的遥测读数、哨兵、3s 老化看门狗、
  助记符断言，以及"告警期间读数不老化"断言（老化场景用
  `defparam TELEM_STALE_DIV=100000` 缩短到 2ms 验证——该值必须显著大于
  一帧 UART 传输时间 ~700us，否则连续两帧之间就会老化，测到的不是设计行为；
  断言流程"帧后 200us 仍新鲜 → 3ms 后变 `----` → 再发一帧又恢复"）。
- Vivado 无头综合/实现/比特流：`BITSTREAM_OK`，DRC 0 Errors，
  `All user specified timing constraints are met`，
  833 LUT（4.00%）/ 488 FF（1.17%）/ 35 IOB（20.59%）。
  （LUT 从上一版的 627 涨到 833，主要来自 16 位十进制拆分所需的常数除法。）
- `gen_mcs.tcl` → `MCS_OK`，`top.mcs` 6,165,628 B。
- 基站固件：`idf.py build` 全量重编 **0 error / 0 编译告警**，
  `base_station.bin` = 930,192 B（1M 分区余 11%）。
- 离线自测：**15/15**（新增场景 15 逐点锁定 `fall_acc_mag_centi_g` 换算与哨兵无歧义）。
- 上板：`program_bit.tcl` → `PROGRAM_OK` + `End of startup status: HIGH`；
  S3 重烧 → `Hash of data verified`；重启日志确认上电首帧为
  `FPGA: TX cmd=0x10 p1=0x00 p2=0xFFFF xor=0x10 [AA 55 10 00 FF FF 10 0D]`
  （xor = 0x10^0x00^0xFF^0xFF = 0x10，逐字节与契约 §4.3 一致）。

### 未覆盖 / 已知问题（需上机）

- **固化后的上电自动启动：目前无法修复，记录如下。**

  Flash 烧写本身是成功的：`Erase Operation successful` /
  `Program/Verify Operation successful`，读回内容与写入的 `top.mcs`
  逐字节一致。

  但**断电再上电时板子不会自动启动**（`DONE` 保持 0，数码管/LED/蜂鸣器
  全无反应）；**手动按一下板上 CONFIG 按钮，立即正常启动**。

  这个现象本身就排除了一大类可能——按下 CONFIG 能起来，说明 Flash 内容
  正确、MSEL 已处于 Master SPI、烧写方式无误、mcs 格式无误（与 Vivado 自带
  样例 `ac701_test.mcs` 结构一致）。**唯一失效的是"上电瞬间的自动触发"**。
  CONFIG 按钮接的是 `PROGRAM_B`（低有效配置复位），它能手动生效而上电不
  生效，指向板级上电复位电路/电源上升沿问题。

  已尝试且无效：XDC 中设置 `BITSTREAM.CONFIG.PROGPIN/INITPIN/DONEPIN =
  Pull-up`（用 FPGA 内部弱上拉替代板上外部上拉）——实测仍必须按 CONFIG，
  已回退该改动。

  **历史事实：该板在本次改动之前无需按 CONFIG，上电即自动启动。**
  本次所有改动均未触及配置电路相关约束（`pins.xdc` 引脚分配、
  `gen_mcs.tcl`、比特流生成参数均未改变），**但无法定位具体致因**。

  详见 `docs/FPGA实验板资料参考.md` §9b 的"已知问题"小节。
  当前绕过方式：上电后按一次 CONFIG（已验证有效），或用 `program_bit.tcl`
  经 JTAG 下载（需电脑）。

- 另需说明：`program_mcs.tcl` 的开发过程走过弯路——早期一直报
  `[Labtools 27-3347] Failure to set flash parameters`，该提示误导排查方向
  （一度怀疑器件型号，实测 14 个不同厂商/容量的器件全部同样报错）。
  真实原因是缺少 JTAG 间接访问 Flash 所需的 **SPI 桥接位流**加载步骤
  （`spi_xc7a35t_pullnone.bit`，藏在 Vivado 安装目录的 `bitfile.zip` 里）；
  GUI 会自动完成这一步，手写 Tcl 不会。脚本现已内置该步骤，
  可稳定烧写成功。

- S3 重烧后数码管读数与助记符目视确认。
- 蜂鸣器响度/音色试听（本次未动 `buzzer_ctrl.v`）。

---

## [2026-10-18] 声光效果增强（载波蜂鸣 / 四态 LED / 分档数码管）+ OLED 中文状态屏

> **协议零改动**：本次只改显示与执行的"表现层"，`AA 55` 帧格式、命令码、
> 状态码与发送时序（契约 §4.1~§4.5）一律不动，S3 侧 `fpga_link` 无需重编即可配套。

### 变更内容

FPGA（`firmware/coprocessor`）：

- **蜂鸣器 `rtl/buzzer_ctrl.v` 改为"音频载波 × 报警节拍"两层驱动**：约 2.7kHz 载波
  （`TONE_HALF_DIV=9260`，可用 `TONE_ENABLE` 关闭）× "响150/停100/响150/停100/响150/静600 ms"
  三短一停节拍；新增 `beat` 输出供 LED 复用。
- **数码管 `rtl/seg_display.v` 按状态分档**：静止/走动向 `S`+状态码右对齐并让小数点
  1Hz 心跳（此前 `seg[7]` 恒 0 未用）；待确认（state_code=2）数字位 4Hz 快闪；
  告警 `FALL--` 由 1Hz 提频到约 3.3Hz，并加 6 位小数点 30ms/步流水动画。
- **新增 `rtl/led_ctrl.v`（16 路软 PWM 亮度引擎）**：告警=与蜂鸣节拍同步爆闪；
  静止=`led[0]` 约 2.6s 呼吸灯；走动=单灯+2 级拖尾环形流水（80ms/步）；
  待确认=KITT 式来回扫描（50ms/步）。`rtl/top.v` 原来的内联 LED 映射改为实例化该模块。
- **`sim/tb_top.v` 适配并加强断言**：软 PWM 下引脚瞬时值不可精确断言，故 LED 断言
  一律改成"观察窗口内是否出现过某形态"的累积标志；新增流水位置推进、KITT 两端到达、
  待确认数字位亮/灭双相位、蜂鸣载波上升沿计数等检查。
- `sim/run_sim.ps1` 与 `rebuild.tcl` 的源文件列表同步加入 `rtl/led_ctrl.v`。
- **新增 `program_bit.tcl`**（无头 JTAG 下载 top.bit，补齐"重建 → 出比特流 → 下载"链路；
  带器件型号护栏，检测到非 `xc7a35t` 拒绝写入），`docs/Vivado工程移植方案.md` 已同步目录与用法。

基站（`firmware/base_station`）：

- **OLED 升级为中文状态屏**：新增 `main/font_cjk16.h`（14 字 16x16 点阵，约 0.5KB）；
  `oled_display.c/.h` 增加 UTF-8 感知混排（ASCII 5x7 + 汉字 16x16 同函数推进）、
  2 倍放大（32x32 大字）与反色/实底绘制三组原语。
- **新屏面布局**：y0~15 反色标题栏「跌倒检测基站」；y16~47 32x32 大号中文状态
  （正常 / 行走 / 疑似跌倒 / 跌倒告警，**告警时整条 2Hz 反色闪烁**）；y48~55 `PKT/SEQ`；
  y56~63 `SD:xx F:xx 坏帧/丢弃`。
- **字模生成器入库**：`tools/font_gen/gen_cjk16.ps1`（本机宋体网格适配渲染 + 墨水居中，
  并打印 ASCII 点阵图供目视校验；脚本刻意保持纯 ASCII，避免 PowerShell 5.1 按 ANSI
  解析带中文注释的脚本）。

### 决策依据

- **音量不足的根因是驱动方式，不是代码参数**：原实现只有 2Hz 通断。对**无源**蜂鸣器
  那只是轻微"咔哒"声，必须在共鸣频率（约 2.7kHz）驱动才有正常声压。板卡资料里蜂鸣器
  引脚取自**电子琴实验** XDC —— 电子琴要求能播放不同音高，强烈指向无源器件，与原注释
  "本期板载为有源"存疑。故保留 `TONE_ENABLE` 开关：默认叠加载波，若实板确为有源且叠加
  后音色变差，置 0 即回到干净通断——一处参数即可回退。
- **节拍改"三短一停"**：恒定 2Hz 通断在现场辨识度低；三短一停更接近真实报警器听感，
  且与 LED 爆闪共用同一 `beat` 包络，声音与光天然同步，无需额外同步逻辑。
- **LED 走软 PWM 而非纯通断**：呼吸灯必须有亮度维度。16 路 8 位 PWM（约 195kHz 帧率）
  在本设计只占 627 LUT / 509 FF（3.0% / 1.2%），代价可忽略。
- **告警 LED 从"全亮"改为"同步爆闪"**：静态全亮信息量低，爆闪在嘈杂现场更醒目且与
  音频同源同相。契约 §4.3 / §4.7 已同步修订，并新增 §4.8 效果定义表（含调参位置）。
- **不做完整中文字库**：GB2312 16x16 约 260KB，与本屏实际用到的十几个词条不成比例；
  按需收录子集（14 字 0.5KB）观感相同。**缺字画空心方框**而非静默丢弃，便于暴露漏收。
- **告警用"整条反色大字"**：OLED 上大面积白底黑字的闪烁比小字远距离可辨；闪烁相位由
  刷新调用计数产生（250ms 刷新 → 2Hz），不为显示引入额外定时器依赖。
- **接受的信息取舍**：屏面让位给中文大字后，原 `AP CSI_FALL_AP` / `IP` 两行与 SD 文件名
  移出屏面（仍完整存在于串口日志与 CSV 文件名中）。演示现场要的是"一眼看到状态"。

### 验证

- **FPGA 无头仿真** `sim/run_sim.ps1`：`SIM RESULT: PASS`，`TB: ALL CHECKS PASSED`，
  9 场景全过（含本次新增的 LED/数码管/蜂鸣断言），负测试（坏校验 / 未知命令 / 重同步）
  零回归。
- **Vivado 无头重建 + 出比特流**（`rebuild.tcl -tclargs --origin_dir .` → `build_bit.tcl`）：
  `BITSTREAM_OK`；综合 **0 error、0 critical warning**；实现 **DRC 0 Errors**；
  **`All user specified timing constraints are met`**；资源 627 LUT (3.01%) /
  509 FF (1.22%) / 35 IOB (20.59%)。产物 `coprocessor.runs/impl_1/top.bit`（2,192,206 B）。
- **基站固件** `idf.py fullclean` + 全量重编：**0 error、0 编译告警**；
  `base_station.bin` = **929,888 B (0xE3060)**，1M app 分区余 **118,688 B (11%)**。
  唯一告警来自 IDF 自带的 `component_validation.cmake`（esp_wifi↔wpa_supplicant 私有
  include 交叉引用），与上一次入库时完全一致、与本改动无关。
- **离线自测 14/14 全过**（`tools/offline_test/logs/offline_test.log`）：本次未触碰
  `fall_core.c` / `log_fmt.c`，属零回归确认。

### 已知事项

- **本次未上板**（只做无头仿真 + 构建）。上板需两项目视/试听确认：
  ① 蜂鸣器是否明显变响、音色是否可接受——若不可接受，把 `TONE_ENABLE` 置 0 重出比特流；
  若只是共鸣点不匹配，可试 `TONE_HALF_DIV=6250`（4kHz）。
  ② OLED 中文是否清晰、有无上下半页颠倒——若颠倒，把字模两半的存储顺序对调即可。
- 契约 §4.8 表里的时长/频率均为**参考默认值**，全部可由 RTL 参数调整。
- `led[15]`（M1）物理坏点维持既有验收豁免：流水/扫描经过该位时现场会看到一个缺口。
- 屏面 `坏帧/丢弃` 计数采用 `a/b` 紧凑写法，图例写在 `oled_display.c` 的状态屏渲染注释处。

---

## [2026-10-18] 判定算法对照文献评审：确认窗口修订 + 姿态门钩子

对照业界同类实现评审跌倒判定（触发本次修订的证据）：

- **KFall 数据集 ESP32+MPU-6050 项目**（github.com/MadlyFriese/esp32-fall-detector，
  线性 SVM + 冲击门限双证据，fall recall 0.954）：
  门限扫描 gate=3.0g 时 fall recall 仅 0.827、gate=1.7g 时 0.896；原文点名
  magnitude-only 的头号误报 "sitting down heavily sails past it"；其
  "活动上下文 + 物理冲击"双证据互证思路与本工程"冲击 + 静止"结构一致。
- **学术阈值法**：Kepski & Kwolek (IET 2017) 以 SV_total > 2.5g 判冲击；
  三段式框架（活动强度 / 姿态 / 转移分析）中本工程缺"姿态分析"一环。

### 修订 1（P0）：PENDING 确认改"持续静止计时 + 观察上限"

旧实现是快照式——只在冲击后恰满 STILL_WINDOW_MS(1.5s) 的那一帧检查是否
静止，存在两条漏报路径：

1. 躺稳后在到期帧恰逢抽动（gyro > 50°/s）→ 退出 PENDING，此后无新冲击不再触发；
2. 倒地后持续挪动超过 1.5s 才静止 → 错过唯一确认时刻。

新实现：持续静止（gyro_quiet && acc_near_g）累计满 STILL_WINDOW_MS 即确认
（被运动打断则计时清零重来）；冲击后 PENDING_MAX_MS(4s，新增宏) 内仍未
确认则按非跌倒退出。上限同时防"碰撞后走动再坐下"被误确认（到期时坐下
静止不足 1.5s）。残余风险（已知并接受）：冲击后 1.5~4s 才坐下静止仍会
误报，由修订 2 根治。

### 修订 2（P1）：姿态门钩子（默认关闭）

`POSTURE_CHECK_ENABLE=0`（fall_core.h）。开启后确认前额外要求：确认时刻
重力方向与"竖直参考"夹角 >60°（躺平）。竖直参考在 IDLE 持续静止 2s 后
自动校准；未校准 fail-open（行为与门关闭完全一致）。整数 Q4 定点实现
（dot²·16 < a2·ref2·cos²θ·16），无浮点无 math.h，溢出有界（函数注释有
分析）。⚠️ 前提是佩戴朝向固定——待成员 B 确定佩戴位置（胸口/腰部 vs
手臂）后再开启。

### 修订 3（P2）：阈值依据回写

IMPACT_THRESH_G 保持 3.0g（演示期压误报优先），头文件注释补 2.5g 学术
基准与 KFall 扫描数据；调参指引交成员 C：拿 SD 卡 CSV 对真实动作做阈值
扫描（文献数据支持在实测基础上向 2.0~2.5g 下调）。

### 回归证据

- 离线自测 11 -> 14 场景全过（`tools/offline_test/logs/offline_test.log`）：
  - 新增 [12] fall_late_still：冲击后挪动 2.2s 才静止 → 确认（旧逻辑漏报）；
  - 新增 [13] fall_boundary_twitch：到期帧恰逢抽动 → 确认（旧逻辑漏报）；
  - 新增 [14] bump_walk_sit：碰撞后走动 3.2s 再坐下 → 不报警（上限防误报回归）；
  - fall_recover 数据延长至 4s（新上限）到期退出，迁移序列不变；
  - fall_lying 确认时刻 2020ms -> 2040ms（+1 帧），迁移序列与帧数断言不变；
  - 原 8 个行为场景 + 3 个 CSV 契约场景全部零回归。
- FPGA 侧零改动：契约 §4 状态码不变，PENDING 显示时间变长仅为时序现象。

---

## [2026-10-18] 真机上板验证：OLED 上线、四幕联调通过、SD 记录打通

### 变更内容

- **首次把新固件（含 OLED/SD 模块）烧上真机验证**（COM4，板上 `USB-Enhanced-SERIAL CH343` 桥）。
- **OLED 上线**：`panel ready: addr=0x3C ctrl=SSD1306 size=128x64`
  → 地址探测命中 0x3C、初始化序列走完，**模块控制器确认为 SSD1306**，
  `OLED_CTRL_SH1106` 保持默认 0 正确（原备用的 SH1106 开关未被触发）。
- **主链路四幕联调通过**，且与离线自测/2026-10-16 上轮实测**逐位一致**：
  收包 `packets=637 frames_ok=637 frames_bad=0`；`WALK -> PENDING seq=25 mag2=90425590`；
  `PENDING -> CONFIRMED seq=99`（距冲击 1517ms，参照 1511ms）；
  `TX cmd=0x01 [AA 55 01 00 00 00 01 0D]`、`TX cmd=0x02 [AA 55 02 00 00 00 02 0D]` 逐字节一致；
  `snap cmd sent to 192.168.4.2:8889`。
- **降级设计**：SD / OLED 任一失败只禁用自身功能，不影响判定与报警；SoftAP / 收包 / 判定 / OLED /
  FPGA 下行全部照常 —— 与 `fpga_link` 失败同策略的容错假设得到验证。
- **新增两个模块未使主链路回归** —— 这是本次最核心的验收结论。

### 决策依据

- **"不回归"的判据是哪些值必须吻合**：冲击帧号与 `mag2`、确认帧号、确认时间窗、
  以及 ALARM/CLEAR 下行帧的逐字节内容。这些是决定告警正确性与 FPGA 能否正确解码的量，
  它们吻合才叫"没回归"；`STATS` 计数只作辅助。
- **离线自测与真机的时间戳口径差异（重要，勿误"修"）**：离线 harness 在解析完一帧后
  才 `now_ms += dt`（第 0 帧记为 t=20ms），真机用帧到达时的 `esp_timer` 时刻，
  因此所有**基于时间的阈值**（如 `MOTION_HOLD_MS=300ms`）在真机上恰好早一帧闭合
  （15 帧 × 20ms = 300ms → `seq=15` 而非 16）。表现为 `seq` 与随之变化的 `mag2` 差 1 帧，
  而 `gyro2` 一致。**这是两侧时间戳约定不同，不是缺陷**，不要为此改动判定逻辑。

- **FatFs 不支持 exFAT 是硬约束**：IDF v6.1 的 `ffconf.h` 中 `#define FF_FS_EXFAT 0` 写死、
  无对应 Kconfig。将来若 C 侧要求大容量卡，只能选 FAT32（MBR），不能指望开 exFAT。

### 已知事项

- **实板 flash 为 16MB**（启动日志 `Detected size(16384k) larger than ... (2048k)`），
  工程仍按 2MB 配置。当前够用；将来若要扩 app 分区或加文件系统，**有 8 倍余量可放宽**，
  不必再迁就 1M 分区。
- **FPGA 本次未接**：声光致动未验，只验到"FPGA 会收到什么帧"（字节级）。
- **OLED 屏显示内容未人工目视确认**（无摄像头）——新模块里唯一未覆盖的验收项。
- **联调时电脑会占用 `192.168.4.2`**（契约中该地址属穿戴端），导致抓拍指令被发到电脑。
  测试场景无害，但正式联调时该地址须归穿戴端。
- 上机操作内容（烧录/联调步骤/排障）按仓库规范**不入库**，在开发者本机手册。

---

## [2026-10-17] 基站接入 OLED 状态屏与 microSD 数据记录

### 变更内容

- **1.3" 四脚 I2C OLED 状态显示**（`main/oled_display.c/.h`）：128x64 八行状态屏，
  显示 AP/IP、判定状态、包与帧计数、SD 文件名与丢弃数、告警与 FPGA 链路状态。
  I2C0（SDA=GPIO4 / SCL=GPIO5），启动自动探测地址 0x3C→0x3D，250ms 刷新且**只刷变化页**。
- **六脚 microSD 数据记录**（`main/sd_log.c/.h` + `main/log_fmt.c/.h`）：SPI2
  （CS=GPIO10 / SCK=GPIO12 / MOSI=GPIO11 / MISO=GPIO13），FATFS 挂载，
  文件名 `DATA_001.CSV` 起按卡上已有编号递增，严格按契约 §2.1 写 CSV。
- **引脚与开关集中点**（`main/board_pins.h`）：新增模块的引脚、控制器型号、
  队列深度、落盘周期、`ENABLE_OLED`/`ENABLE_SD_LOG` 开关全部收在一处，现场改线只改这里。
- **接线表交付**：新增 `hardware/schematics/基站接线表.md`（契约 §5.1 第 1 项），
  含全量接线、电平要求、引脚避让清单与"改线改哪里"对照表。
  **按仓库既有规范，上机操作内容不入库**（见下方决策）。
- **契约 §2.1 订正**：`State` 列由 3 值改为与 §4.3 一致的 4 值；补明
  `AccX~GyroZ` 为原始 int16、`CSI_Variance` 本期占位 0、行尾 LF。
- **离线自测扩到 11 场景**：新增 3 个 CSV 契约场景（表头逐字节比对、行格式与
  字段数、极值与缓冲区过小可检出），直接编译仓库 `log_fmt.c` 断言。

### 决策依据

- **不用 IDF 内置 SSD1306 驱动（重要）**：`esp_lcd_panel_ssd1306` 的 `draw_bitmap`
  依赖 `0x21/0x22`（设置列/页范围）——那是 SSD1306 的**水平寻址**命令，
  **SH1106 不支持**。而 1.3" 四脚模块两种控制器都常见（本机到货型号待上板确认）。
  故自写约 250 行精简驱动，统一走**页寻址**（`0xB0|page` + 列地址半字节），
  两种控制器一套代码，差异只在初始化序列的电荷泵命令与列偏移
  （`OLED_CTRL_SH1106` 宏切换）。这样既不赌模块型号，也不引入新组件依赖。
- **写卡必须离开收包任务**：SPI+FATFS 单次写卡可达数十至上百毫秒，若在 50Hz
  收包任务里 `f_write`，会打乱 `SO_RCVTIMEO` 100ms 节拍与 `fall_detector_tick`，
  直接破坏已验证的判定时序。故采用**环形缓冲 + 独立低优先级任务**：
  生产者 `xRingbufferSend` 超时 0（绝不阻塞），队列满即丢并计 `DROP`。
- **CSV 格式抽成纯 C99 模块**：与 `fall_core` 同一纪律——能被宿主机离线自测
  编译断言"文档写的 = 固件写的"，杜绝接口漂移。`log_fmt.c` 只依赖 stdint/stddef/stdio。
- **六轴写原始 int16 而非浮点**：契约 §1.2 空口传的就是原始 ADC 值，落盘保持无损；
  浮点换算交代换常数（2048 LSB/g、16.384 LSB/°/s）留给 C 侧，也免去 MCU 浮点格式化开销。
- **`State` 列订正为 4 值**：原 §2.1 写 3 值（`2=跌倒`）与 §4.3 的 4 状态码矛盾，
  会把 `FALL_PENDING` 误读成"已跌倒"。以 §4.3 为准统一。**跨团队影响：成员 C
  若已按 3 值写解析脚本需同步更新。**
- **容错一律"降级不阻断"**：SD 挂载失败、OLED 无应答、写卡中途失败，都只禁用该功能
  并打日志，判定与声光报警主链路完全不受影响（与 `fpga_link` 失败同策略）。
- **上机操作内容不入库（沿用既有规范）**：仓库只放**接线与引脚事实**（契约 §5.1 要求的
  基站电气接线表），烧录/连热点/发假包/每步现象/排障等实操步骤一律留在开发者本机手册。
  理由与既有约定一致：仓库是**设计与接口的权威记录**，而实操手册随演示现场、板子个体
  与操作者习惯频繁变动，入库会反复产生无意义 diff，且容易被误当作接口定义引用。

### 验证

- `idf.py fullclean` 后**全量重编 0 error、编译告警 0**（1085/1085 步，
  `Project build complete`，退出码 0）。
  另有 5 条 CMake 提示来自 IDF 自带的 `component_validation.cmake`
  （esp_wifi ↔ wpa_supplicant 私有 include 目录交叉引用），属 IDF 内部提示，
  本次改动前后完全一致、与新增代码无关。
- `base_station.bin` = **928,320 B (0xE2A40)**，1M app 分区余量 **120,256 B (11%)**
  —— 仍在 `CONFIG_PARTITION_TABLE_SINGLE_APP`（1M）内，**无需改分区表**。
- 离线自测 **11/11 全过**：原 8 场景无回归 + 新增 CSV 表头/行格式/极值与截断。
- **`ENABLE_OLED` / `ENABLE_SD_LOG` 四种组合全部 0 error 0 warning 编译通过**，
  体积分别为：1/1 = 928,320 B（余量 11%）、1/0 = 825,920 B、0/1 = 907,968 B、
  0/0 = 805,024 B。0/0 与改动前的 804,864 B 仅差 160 B——
  即**模块全关时新代码几乎不占空间**，可放心按线材/进度分阶段上板。
- **上板实测本期未做**（模块刚到、代码先落地）。上机步骤（接线→烧录→连热点→
  发假包→每步现象→排障）按仓库规范**不入库**，由开发者在本机自行记录。
  上板若与预期不符，改动点见 `hardware/schematics/基站接线表.md` §3。

### 已知事项

- **上板需确认的两件事**：① OLED 是否横向错位 2 列（是则 `OLED_CTRL_SH1106` 改 1）；
  ② 六脚 SD 模块丝印标 `3.3V` 还是 `5V`（决定供电接法，信号侧始终 3.3V）。
- **GPIO4/5/10~13 的可用性需对照实板丝印**：已避开 strapping（0/3/45/46）、
  flash/PSRAM（26~32）、USB（19/20）、控制台（43/44）与既有 GPIO17；GPIO10~13
  按 ESP32-S3 SPI2 外设默认脚使用。
- **不支持 SD 运行中热插拔重挂载**：六脚模块无卡检测脚；拔卡后写失败即停止记录，
  需重新上电恢复。队列丢弃数与 UDP 丢包是两个独立计数（OLED 上 `DROP` 与 `BAD`）。
- FatFs 写入为**1 秒周期 `fsync`**（状态变化时立即落盘），故掉电最多损失约 1 秒数据；
  告警时刻前后的记录会优先落盘。

---

## [2026-10-16] 真机联调：S3 主链路上板验证通过 + 三处实测修正

### 变更内容

- **S3 主链路真机验证通过**（COM4 实板，未接 FPGA）：SoftAP / UDP 收包 /
  18B 帧解析 / 跌倒判定 / UART 下发全链路，日志特征值与离线自测逐位一致
  （walk seq=16、冲击 seq=25、确认 seq=99，时序 1511ms，均吻合）。
- **实测修正 1（UART）**：`uart_driver_install` rx 缓冲传 0 被驱动拒绝
  （legacy 驱动要求 > HW FIFO 128），`fpga_link.c` 改为 256。
- **实测修正 2（引脚）**：课程资料的 UART 引脚 F12/F13 在本板接的是
  **板上 USB-UART 桥**（右侧 UART USB 口），排针未引出——S3 对接改用
  扩展排母空闲脚 **B15**，`pins.xdc` 已改并重新出比特流（IO 报告确认
  `rxd → B15`）。勘误已写回《FPGA实验板资料参考.md》§4。
- **实测修正 3（告警解除语义，重要）**：
  - 初版为 `ALARM_HOLD` 定时 10s 解除——人躺地上昏迷时穿戴端仍推流
    （静止特征），10s 一到报警自停，人还在地上报警器却闭嘴，语义错误；
  - 第一轮修补（无帧 tick 兜底）又被 3s 掉线保护提前掐断告警（实测
    "刚发就报警结束了"）；
  - **最终语义：告警为锁存，唯一解除判据 = 持续起身活动**
    （角速度 > GETUP_GYRO_DPS 持续 GETUP_HOLD_MS，对齐 fall_recover
    的"爬起"判据）。数据停摆时告警保持——人昏迷 + 设备故障恰是最
    需要报警的时刻。`fall_detector_tick()` 保留，仅负责非告警态掉线保护。
- **离线自测扩到 8 场景**：新增"停摆保持告警"与"起身解除"（fall_getup
  场景，自带爬起段 700ms）两个回归测试；演示剧本一条命令完成
  "走动→摔倒→报警→被扶起"。
- **FPGA 上电自检（POST）**：上电 2s 强制告警显示（FALL-- 闪烁 + 蜂鸣 +
  LED 全亮）后自动待机，单板验证声光链路，契约 §4.7。

### 决策依据

- 告警解除的三次迭代教训：**解除判据必须是物理事件（人起来了），
  不能是时间**。定时解除在"人昏迷躺地"这一最需要报警的场景下失效；
  掉线解除在"演示停发数据"场景下把告警掐成 1~3 秒。锁存 + 起身判据
  是跌倒报警器的标准语义。
- 引脚勘误流程：实板照片核对排针丝印（B15/C14/D14... 与 A2/B1/G2...），
  确认 F12/F13 未引出，勘误写回参考文档防止后人重蹈。

### 已知事项

- 演示节奏：告警锁存期间（人未起身）新场景数据会被忽略——先发 walk/
  fall_getup 解除告警再继续。
- **部署要点**：Vivado Program Device 为易失烧录（FPGA SRAM，断电即丢）；
  部署须固化到板载配置 Flash。实测芯片为**美光 Micron N25Q32-3.3V**
  （Vivado 自动识别：Mfg ID 20 / Type ba / Capacity 16），列表直接选
  `n25q32-3.3v`；固化文件用 `gen_mcs.tcl` 由 top.bit 生成 top.mcs
  （Program Configuration Memory 只收 .mcs/.bin）。固化后改 RTL 需重固化，
  否则断电回旧版。无头烧写脚本见 `program_mcs.tcl`。
- （其余同 2026-10-15 条目）

---

## [2026-10-15] 主链路落地：跌倒判定 → 声光报警（S3 + FPGA 各自成立）

### 变更内容

- **板间协议**：S3 → FPGA 8 字节 UART 控制帧协议定稿并落实现，
  权威定义见《团队协作规范与接口契约.md》§四（成员 A 域内协议，单列一节）。
- **S3 侧**（`firmware/base_station`）：SoftAP + UDP 收包 + 18 字节姿态帧
  流式解析 + 三段式跌倒判定状态机 + UART 下发报警命令；判定核心
  `fall_core.c/.h` 为纯 C99、零平台依赖，阈值集中头文件顶部（对应契约 §2.2 交付形态）。
- **FPGA 侧**（`firmware/coprocessor`）：新增 `uart_rx` / `cmd_decoder` /
  `seg_display` / `buzzer_ctrl` 四模块，重写 `top` 与 `pins.xdc`
  （补全 rst_n 上拉、UART、数码管、蜂鸣器约束）。
- **无头验证**（全程无 GUI、无真机）：
  - S3：`idf.py build` 全量重编 0 error；
  - 判定逻辑：离线自测直接编译仓库 `fall_core.c` 运行（宿主 lcc64），
    6 场景状态跳转全过；
  - FPGA：`sim/run_sim.ps1`（xvlog/xelab/xsim 命令行）9 场景断言全过；
  - FPGA 综合/实现/比特流：`build_bit.tcl` 无头完成，
    `coprocessor.runs/impl_1/top.bit` 已生成（0 error，唯一 warning 为
    `txd` 恒接常量，属设计意图）。
- **工程维护**：`rebuild.tcl` 含全部 5 个 RTL 源文件 + 仿真 testbench，
  原地重建（`-force` 可重复执行），并验证工程内 `SRC_COUNT=5`。

### 目录布局调整（同日）

- RTL/约束从 Vivado 工程数据目录 `coprocessor.srcs/` 迁出至
  `rtl/` 与 `constrs/`。原因：`coprocessor.srcs` 属工程生成物，
  `create_project` 原地重建时把"该目录已存在"判定为工程冲突报
  `Common 17-53`；迁出后 `rebuild.tcl -force` 可原地重复重建，
  源码也永远不会被重建脚本清除。工程文件仍为
  `firmware/coprocessor/coprocessor.xpr`（与 GUI 打开习惯一致）。

### 板间独立验证

- **FPGA 单板**：新增上电自检（`top.v` 参数 `POST_CYCLES`，默认 2s）——
  上电强制走告警显示（FALL-- 闪烁 + 蜂鸣 + LED 全亮）后自动待机，
  不接 S3 即可验证数码管/蜂鸣器/LED 全链路；协议契约 §4.7。
- **S3 单板**：`send_stream.py` 发假包 + 串口 `TX cmd=` 日志即可完整
  验证判定与下行编码，不需要 FPGA 在场。

### 决策依据

- 判定逻辑与平台解耦：离线自测与 S3 固件编译**同一份源文件**，杜绝
  "两份实现漂移"；离线测过的合成帧直接用于上板发假包。
- 解析/解码两侧均采用**滑动窗口逐字节校验**而非"状态机 + 固定索引"：
  重同步由结构保证，无错位风险（固定索引方案实测会把 60 帧误判成 237 帧）。
- CSI 占位（`csi_stub`）：真实提取需穿戴端在场，本期只留接口；
  `csi_ready()` 恒 false，主程序据此跳过 CSI 判据，占位值不参与判定。

### 已知事项

- `xsim` 在本仓库深层路径直接运行会崩溃（`Could not open file mapping object`），
  同一快照在 `%TEMP%` 正常——路径相关共享内存问题，`run_sim.ps1` 已内建规避
  （elaborate 在仓库、运行切临时目录后拷回产物）。另发现该崩溃**偶发**于
  临时目录运行中，表现为仿真中途终止且日志无 `ALL CHECKS PASSED`——
  runner 会据此判 FAIL，重跑即可，属工具稳定性问题非 RTL 问题。
- 蜂鸣器按**有源**实现（2Hz 通断方波）；若实板为无源需在 `buzzer_ctrl.v`
  内叠加音频载波。数码管位选/段码极性做成 `seg_display.v` 参数，上板不符直接覆盖。
- **旧工程文件陷阱**：若本机留有 2026-10-14 的旧 `coprocessor.xpr`
  （只登记了旧 top.v），打开会报 `module 'uart_rx' not found`——
  删掉旧工程文件重跑 `rebuild.tcl` 即可。
- 上机操作文档按仓库结构规范**不入库**，由开发者自行保管，仓库内不引用。

---

## [2026-10-14] 撤除 STM32 协处理器，基站改为 S3 + FPGA 双板架构

### 变更内容

- 删除 `firmware/coprocessors/stm32/` 整个 STM32F401RE 工程（CubeMX 工程 + CMSIS/HAL 驱动 + 启动文件 + 链接脚本）。
- `firmware/coprocessors/` 目录更名为 `firmware/coprocessor/`，仅保留 Artix-7 FPGA 工程。
- FPGA 工程由 `fpga` 重建为 `coprocessor`，源码内容（`top.v`、`pins.xdc`）与原工程逐字一致，仅工程名与路径变化。
- 全仓库文档中 STM32 相关表述同步清除，`README.md` 硬件拓扑描述同步更新。

### 决策依据

撤除 STM32 不是因为"不好用"或"做不出来"，而是因为在系统既定架构下，**STM32 找不到任何技术上不可替代的职责**。逐项排查结论如下：

| 候选角色 | 结论 |
|---|---|
| 姿态解算 | **数据第二落点，结构性多余。** MPU6050 长在穿戴端，姿态数据经 WiFi/UDP 进入系统的第一接收者必然是 ESP32-S3。STM32 若要参与，只能由 S3 经 UART 转手，形成"穿戴端 → S3 → STM32 → 解算 → S3"的环路。且 F401RE @84MHz 单核的滤波算力开销本身极小，S3 双核 240MHz 做同一件事更轻松，卸载无收益。 |
| 报警执行（蜂鸣器/继电器/指示灯） | **与 FPGA 板全面重叠且劣势。** NUCLEO-F401RE 板载输出资源仅 1 颗用户 LED（PA5）；FPGA 实验板有 16 颗 LED + 板载蜂鸣器 + 6 位七段数码管 + 8 位 DAC。告警表达 FPGA 板占绝对优势，且无需外接模块。 |
| SD 卡数据记录 / OLED 驱动 | S3 经 SPI/I2C 直接驱动均为标准做法；经 UART 转给 STM32 再操作纯属增加故障点。 |
| CSI 特征卸载计算 | **CSI 产生于 S3 的 WiFi 外设内部**，任何卸载都必须先把数据搬出 S3，搬运成本高于算力节省。 |
| 协议桥接（S3↔FPGA 中转） | 两者均为 3.3V UART，可直接对接，中间加一块板纯增故障点。 |
| 看门狗 / 系统健康监控 | 技术成立，但 S3 自带 Task WDT + RTC WDT，对本项目 3 分钟演示场景零收益。 |
| FPGA 比特流加载（MCU 经 SPI 配置） | 技术成立，但 JTAG 下载已验证可用，零演示收益且需额外接线与比特流存储。 |
| 双通道冗余判决 | **伪冗余。** STM32 与 S3 读取同一份源自 S3 的数据，数据错误时两者会一起错；真冗余需要接入独立传感器，与项目"废除外置独立信标"的前提冲突。 |
| 接入本地有线传感器构成"WiFi 无线感知 + 有线本地感知"双通道 | 唯一非二道贩子式的角色，但**直接破坏项目核心卖点**（README：废除外置独立信标，复用 UDP 报文作为空间多径激励源），且需追加硬件采购。 |

补充一点常被用来支持此类协处理器的论点："裸机执行确定性好，不受 WiFi 协议栈抖动影响"。该论点本身成立，但本项目的跌倒判据是"合加速度冲击阈值 + 静止窗口"，UDP 包抵达 S3 后即可立即判定，**不存在需要确定性硬实时环的处理环节**，故该论点不适用于本系统。

### 影响

- 系统仍是**三处理器异构**：ESP32-S3（感知主控 + 网络中枢）、Artix-7 FPGA（硬件级并行声光告警）、ESP32-CAM（穿戴端抓拍节点）。变化在于**基站桌面由三块板减为两块**，"多层次异构边缘协同"的论述不受影响，且每一级的分工更清晰。
- ⚠️ **跨团队影响**：成员 C 正在按"三处理器/三块板"撰写《作品设计报告》，需同步修改相关表述。
- 演示桌上减少一块板、一条 ST-Link 线、一组会松的杜邦线，现场稳定性提升。

### 原 STM32 工程留档（便于将来捡回）

| 项 | 值 |
|---|---|
| 板型 | NUCLEO-F401RE |
| MCU | STM32F401RETx（Cortex-M4，84 MHz，FPU fpv4-sp-d16 hard ABI） |
| 生成工具 | STM32CubeMX 6.18.0 / STM32CubeIDE 2.2.0 |
| 固件包 | STM32Cube FW_F4 V1.28.3（HAL V1.8.5） |
| 已配置外设 | USART2（PA2 TX / PA3 RX，115200 8N1）、GPIO（PA5=LD2 输出，PC13=B1 输入） |
| 已验证 | 编译 0 error 0 warning；烧录成功；LD2 以 1 Hz 闪烁 |
| 删除路径 | `firmware/coprocessors/stm32/`（git 历史中仍可检索） |

> 将来若需恢复，可从 git 历史取回工程骨架，CubeIDE 导入 `.ioc` 即可重新生成代码。

---

## [2026-10-14] FPGA 工程重建，`.xpr` 不再纳入版本控制

### 变更内容

- FPGA 工程由 `firmware/coprocessors/fpga/`（工程名 `fpga`）重建为 `firmware/coprocessor/`（工程名 `coprocessor`）。
- `.gitignore` 新增 `*.xpr`，Vivado 工程文件不再入库。

### 决策依据

`.xpr` 是 Vivado 的**工程状态快照**而非工程定义，其内部写死绝对路径。实测（Vivado 2026.1）将 `.xpr` 与源码复制到新路径后打开：工程"能打开"、综合能跑完，但**文件列表解析不可靠**——源码目录含 2 个文件，工程只认到 1 个，存在约束文件未加载却综合通过的隐患。

改为只纳入源码（`top.v`、`pins.xdc`）后，工程可在任意机器上由导出脚本重建。

### 补充：手写 glob 自动发现脚本方案已否决

曾提出用 `glob` 自动扫描源文件以"加文件即生效、脚本永不改"，实测证伪：

- `glob ... ** *.v` 在本机 Vivado 2026.1 的 Tcl 环境下**不递归**，子目录内文件被静默漏掉，综合报 `module 'nested' not found`
- 文件类型会扩展（`.vhd`/`.vh`/`.sv`/`.xci`/`.bd`），每次扩展都要改脚本，漏改后果是静默失败
- `add_files` 不设置 file_type 属性会退回默认值，`.vh` 头文件、`.xdc` 约束、VHDL 2008 开关等专门属性会丢失

改用 Vivado 官方 `write_project_tcl` 导出重建脚本，实测换路径 + `--origin_dir` 覆盖后，源文件与约束文件均正确加载、综合 0 error。完整方案见 [Vivado工程移植方案.md](Vivado工程移植方案.md)。

---

## [2026-10-14] 三块板骨架初始化完成（基线）

> 本条目为对既有事实的记录，作为后续变更的基线。

- `firmware/base_station`：ESP32-S3，ESP-IDF v6.1，`idf.py` 可编译/烧录/运行，串口可观测初始化信息。
- `firmware/coprocessor`（原 `fpga`）：Artix-7 `xc7a35tftg256-1`，Vivado 2026.1，50 MHz/D4，16 LED 分频闪烁，下载日志 `End of startup status: HIGH`。
- `firmware/coprocessors/stm32`：STM32F401RE，LD2 1 Hz 闪烁（工程已于同日撤除，见上文）。

**已知板卡个体问题**：`led[15]`（M1）在该 FPGA 板上物理不亮，属板卡硬件个体问题，非工程问题，验收时忽略。
