DerekWangHUZ/sice-huawei-cup-wireless-2026/(commit log)

2026-10-13 feat(firmware): add skeleton projects for all three board modules
    - base_station: ESP-IDF v6.1 project for ESP32-S3 (idf.py, target esp32s3)
    - coprocessors/stm32: CubeMX/CubeIDE project for NUCLEO-F401RE (LD2 blink)
    - coprocessors/fpga: Vivado RTL project for Artix-7 (LED blink)
    - docs: add FPGA board reference and member A task status
    - hardware: add FPGA board photo
    - remove .gitkeep placeholders now that directories contain real content
2026-10-14 chore: remove STM32 from architecture, add FPGA rebuild script and docs
    Removes the STM32 coprocessor from the project architecture and simplifies
    the FPGA to a standalone coprocessor under firmware/coprocessor. Adds a
    Vivado rebuild.tcl script to reconstruct the FPGA project from source,
    since .xpr files contain absolute paths and are now gitignored. Updates
    README, collaboration docs, and .gitignore accordingly, and introduces
    new docs (CHANGELOG, Vivado migration plan, FPGA board reference,
    member A status).
2026-10-15 feat: implement fall-detect -> alarm chain on S3 + Artix-7 (headless verified)
    - S3: SoftAP/UDP8888, 18B frame parser, fall state machine (latched alarm,
    released by get-up motion), UART control link (fpga_link, rx buf fix)
    - FPGA: uart_rx/cmd_decoder/seg_display/buzzer_ctrl + power-on self-test;
    rxd on B15 (F12/F13 are on-board USB-UART bridge, not exposed)
    - verification: idf.py build clean; 8 offline scenarios; xsim 9 scenarios;
    synth/impl/bitstream + top.mcs for flash programming
    - layout: RTL out of coprocessor.srcs into rtl/, constrs/, sim/
2026-10-17 feat(base-station): add OLED status display and microSD CSV logging
    - oled_display: self-written page-addressing driver for 1.3" I2C
    SSD1306/SH1106 (IDF built-in ssd1306 panel relies on horizontal
    addressing 0x21/0x22 which SH1106 lacks); mutex-protected status
    snapshot, dedicated low-priority refresh task
    - sd_log: producer-consumer ring queue so SPI/FATFS writes (tens to
    hundreds of ms) never block the 50Hz receive & fall-detect path;
    per contract §2.1 writes /DATA_NNN.CSV with auto-increment numbering
    - log_fmt: pure C99 CSV formatter, locked byte-exact by host offline
    test to prevent doc/firmware interface drift
    - board_pins.h: centralized pins & feature switches (I2C0 GPIO4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
2026-10-18 feat(base-station): sustained-stillness fall confirmation + optional posture gate
    - PENDING confirm: snapshot-at-expiry -> continuous stillness timer (STILL_WINDOW_MS) + PENDING_MAX_MS 4s observation cap; fixes two miss paths (twitch at expiry / stillness arriving late)
    - posture gate hook POSTURE_CHECK_ENABLE (default off): lying-orientation check vs auto-calibrated vertical reference, integer Q4 math
    - IMPACT_THRESH_G kept 3.0g; header notes cite Bourke/Kepski 2.5g and KFall gate sweep (3.0g -> recall 0.827)
    - offline tests 11 -> 14 scenarios, all pass (fall_late_still, fall_boundary_twitch, bump_walk_sit); ESP-IDF build verified
    - docs: CHANGELOG, contract 2.2, member-A status (incl. 2026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
2026-10-18 feat: add flash programming script and rewrite 7-seg display as status + live telemetry
    - Add `program_mcs.tcl` to burn `top.mcs` into the board's configuration
    flash (previously only JTAG SRAM programming was possible, so config
    was lost on every power cycle). Pins the memory part (n25q32), enables
    ERASE/PROGRAM/VERIFY, and guards against wrong device IDs.
    - Add `CFGBVS`/`CONFIG_VOLTAGE` to `pins.xdc` to clear DRC warnings.
    - Rewrite `seg_display.v`: 6-digit display now shows a 2-char status
    mnemonic (St/Go/Pd/AL) plus a 4-digit real-time total-acceleration
    readout in g units, instead of mostly-static digits. Extend segment
    table to cover digits 4-9 and new letters; drop the dec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
2026-10-19 feat(coprocessor,base-station): OLED multi-page UI, keypad setup, demo mode
    FPGA coprocessor:
    - add uart_tx.v and input_ctrl.v: UI uplink (0x80 snapshot / 0x81 key
    event), 4x4 keypad scan with 20 ms debounce, DIP switch debounce,
    local demo scene control
    - cmd_decoder.v: add 0x03 SET_AUDIO command and ever_linked flag
    - seg_display.v: word display (HELLO/rEAdy/run/FALL/N.NNG), 3 s
    telemetry staleness watchdog, glyph self-test
    - buzzer_ctrl.v: runtime mute/tone, pending beep, three-tone audition
    - led_ctrl.v: 12-LED effect engine (breathe/chase/KITT/strobe) plus
    link LED; LED12-16 disabled; link LED dark while idle
    - top.v: display arbitration (real alarm/POST/demo), disabled-LED mask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
2026-10-19 feat(wearable): integrate async capture firmware and /pic photo page
    - Add UDP 8889 capture command handling (55 AA 01 FF) with an asynchronous
    capture worker task so the 50 Hz attitude stream never blocks, plus
    non-blocking flash pre-warm for photo capture.
    - Add /pic HTTP endpoint serving the latest captured photo.
    - Exclude 192.168.4.2 from base station DHCP pool to reserve the wearable's
    static IP; update README capability/port docs and record the change in
    CHANGELOG; adjust sw[9] -> sw[2] DIP assignments and OLED settings page
    count (8 -> 9).
2026-10-19 fix(wearable,base-station): repair capture command port and harden runtime
    Wearable (ESP32-CAM)
    - Bind the capture command port with udp.stop() before udp.begin(8889).
    A failed bind while WiFi was still down left the socket half-open, so
    later rebinds failed too and commandPortReady stayed false forever:
    checkCaptureCommand() returned early, giving no flash, no photo and a
    permanent 404 on /pic.
    - Disable the brownout detector through RTC_CNTL_BROWN_OUT_REG, which is
    DR_REG_RTCCNTL_BASE (0x3ff48000) + 0xd4 = 0x3ff480d4.
    - Add wifi_keepalive(): poll every 3 s, reconnect after 6 s offline and
    re-bind UDP 8889, so a base-station reboot needs no manual power cycle.
    - Retry WiFi.begin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
2026-10-20 docs: clarify air-interface communication-sensing description in README
    Update the air-interface description to specify that UDP packets carry
    IMU telemetry as the primary sensing feedback channel, with Wi-Fi CSI
    support reserved for future use. Fall detection currently relies on
    six-axis IMU data as the main criterion.
2026-10-29 feat(base-station): implement real CSI capture + variance stats, restore wearable camera full function, update docs and offline tests
    - base_station: add csi_real.c (ESP-CSI LLTF callback capture) and csi_stats.c/.h (pure C99 per-subcarrier amplitude variance sliding-window statistics)
    - base_station: CMakeLists.txt supports -DBS_CSI_IMPL=real compile-time stub/real switching (default stub keeps historical behavior)
    - base_station: fall_core decision reserved CSI variance auxiliary criterion (CSI_JUDGE_ENABLE default off; enable after sigma_csi calibration)
    - base_station: integrate csi_feed_packet() at UDP posture packet settlement point to achieve "packet rate = CSI window rate" throttling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
2026-10-31 feat(base-station): CSI 初始化加固（promiscuous/首帧延迟/双配置）并定位 v6.1 SoftAP ESP_FAIL
    - csi_init 内置 esp_wifi_set_promiscuous(true)（v6 起 CSI 与混杂模式耦合）
    - CSI 初始化改为首帧延迟触发（csi_late_init_if_needed）：SoftAP 完全就绪且 STA 推流后才执行
    - set_csi_config 双组合依序尝试（LLTF-only / LLTF+HT-LTF）
    - 头注同步启用前置（CONFIG_ESP_WIFI_CSI_ENABLED 与编译注入兜底）与 v6.1 SoftAP 已知限制
    - 实测坐实：满足全部前置后驱动仍以 ESP_FAIL 拒绝 SoftAP CSI（未文档化），跟踪于 issue #4
    - README/契约/成员A状态 同步当前口径；CHANGELOG 记录三层排查与验收证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
